isliulin/MingRui/Shell/面板壳体.STEP

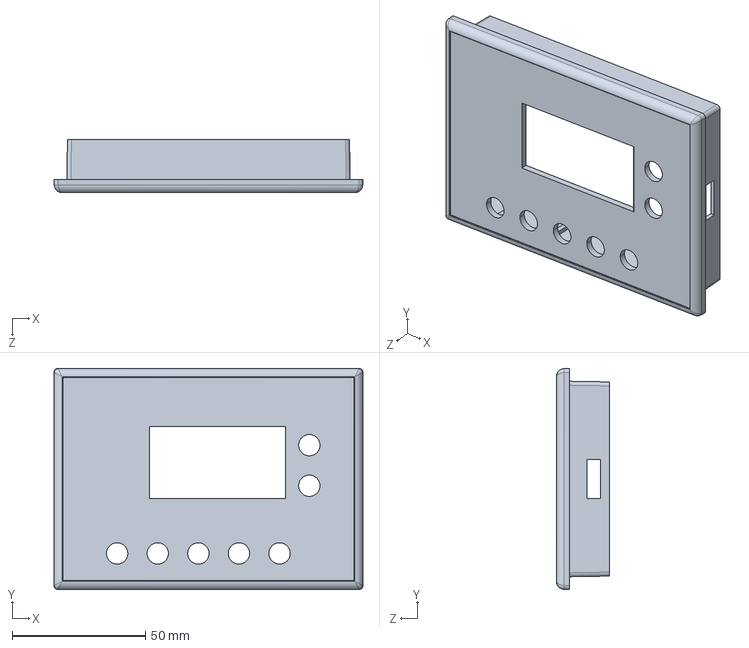
[picture p1: CAD file, 2016-09-27]
Shell/面板壳体.STEP
116.0 x 83.0 x 20.0 mm
