isliulin/MingRui/Shell/壳体后盖.STEP

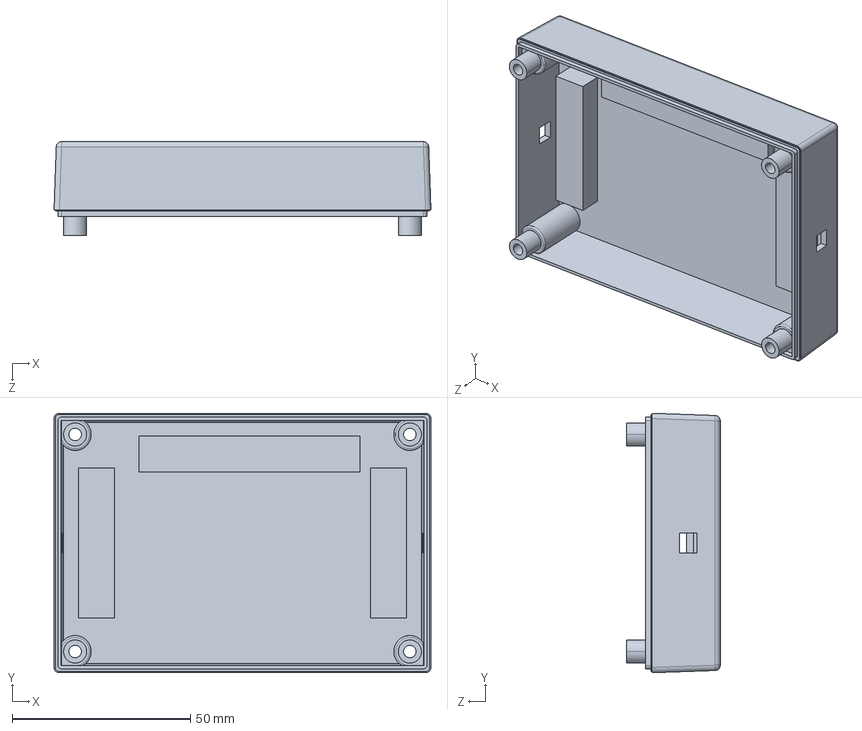
[picture p2: CAD file, 2016-09-27]
Shell/壳体后盖.STEP
105.9 x 72.9 x 26.3 mm
