isliulin/MingRui/(list of files, cad)

Other CAD files:
PCB/KYJ.DWG
Shell/壳体后盖.x_t
Shell/面板壳体.x_t
