isliulin/MingRui/DOC/test.txt

2016-8-25
出现厂家参数设置数值混乱，导致过温保护。重新设置参数后运行正常。

问题建议：保存参数时出现错误，建议加大电源电容。检测到断电时，先关闭液晶背光，再保存数据。

2016-8-26
再次报告出现过温保护，无法清除。检查停机温度设置值是151，改成105后，故障可以清除，能正常启动。

问题建议：检查代码。保存参数时是否出现问题。
