isliulin/MingRui/PCB/KYJ.PDF

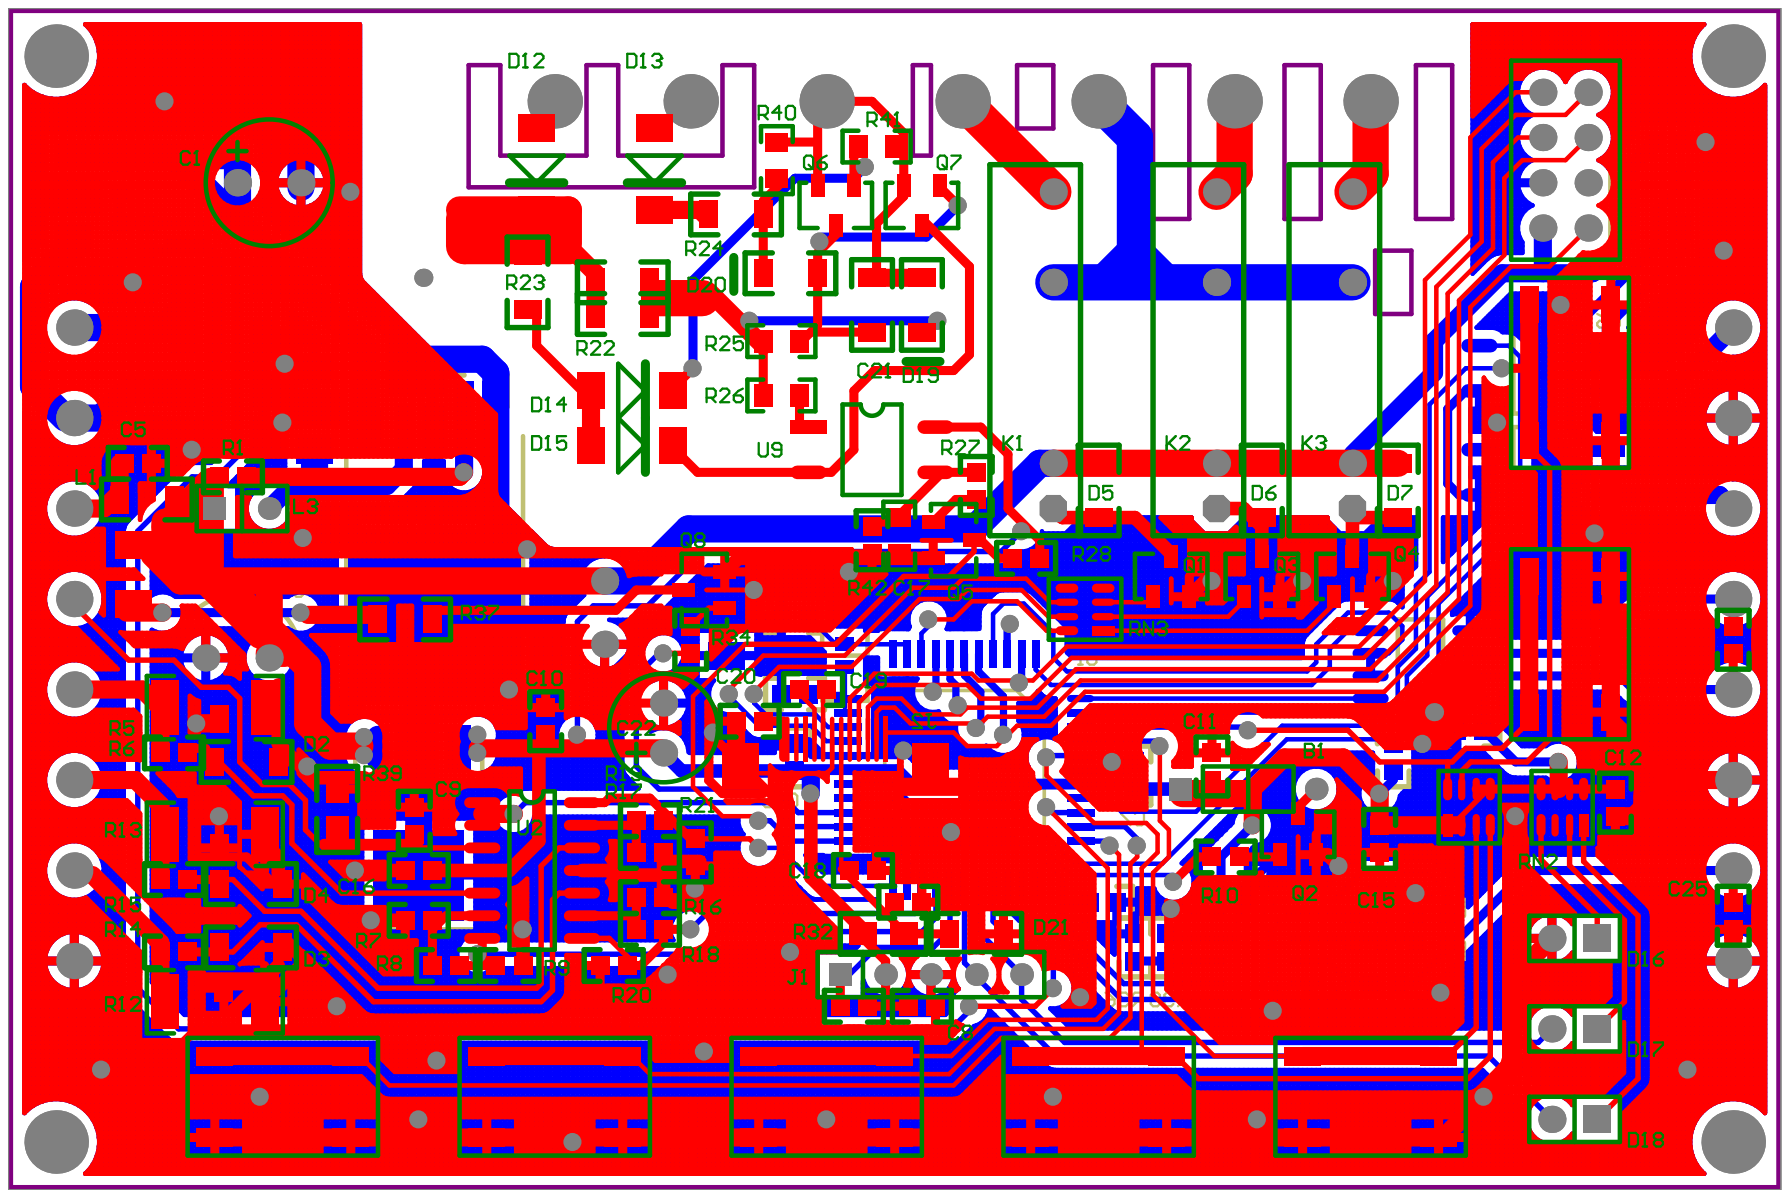
[picture p3: page 1]

Board St
