isliulin/MingRui/(list of files, drawings)

Other design files:
PCB/KYJ.PCB
PCB/KYJController.PCB
PCB/矩阵开关.pcb
