isliulin/MingRui/KYJ.X/SRC/KYJDEF.c

#include "KYJDEF.h"
#include "LCD_LIXIAN.h"
#include "key.h"
#include "adc.h"
#include "EEPROM.h"
#include "delay.h"

volatile unsigned int nADVref=5000;  //AD参考电压，单位：mV
struct KYJ_s sKYJ;
bit bRefreshInterface;
unsigned char nMenuIndex;  //当前菜单序号  1-运行参数；2-用户参数；3-厂家参数；4-注册参数；5-用户密码
unsigned char nParamIndex;   //当前参数序号
unsigned char nDigitIndex; //当前数位
int nParamValue;
int nPassValue;

unsigned int nCurrentLimit12Count;
unsigned int nCurrentLimit13Count;
unsigned char nCurrentLimit15Count;
unsigned char nCurrentLimit16Count;
unsigned char nCurrentLimit20Count;
unsigned char nCurrentLimit30Count;
unsigned char nCurrentLimit0Count;
unsigned char nCurrentNotBalanceCount;
unsigned char nCurrentNotBalance0Count;


unsigned long nCurrent;  //电流采样累加值
unsigned char nCurrentSampleCount;  //电流采样次数，1ms采样一次，每20ms（对应50Hz）计算平均值
unsigned long nLongTemp; //32位临时变量
bit nRet;
int nSampleValue;
unsigned int nLeftTime;
void KYJ_Init(void)
{
    nCurrent=0;
    nCurrentSampleCount=0;
    nCurrentLimit12Count = 0;
    nCurrentLimit13Count = 0;
    nCurrentLimit15Count = 0;
    nCurrentLimit16Count = 0;
    nCurrentLimit20Count = 0;
    nCurrentLimit30Count = 0;
    nCurrentLimit0Count = 0;
    nCurrentNotBalanceCount = 0;
    nCurrentNotBalance0Count = 0;
    
    sKYJ.nStatus = STATUS_POWERSTOP;
    sKYJ.nFaultFlag = 0;
    sKYJ.nStatusTimeElapse = 0;
    sKYJ.nInterface = 0; //设成0后会自动切换到main界面
    sKYJ.nInterfaceTimeElapse = 0;
    FAN_SW_OFF;
    MOTOR_SW_OFF;
    LOAD_SW_OFF;
}

void KYJ_Param_Default(void)
{
    sKYJ.nPressure = 0;
    sKYJ.nTemperature = 0;
    sKYJ.nVoltage = 0;
    sKYJ.nValidateParamResult = 0;
    sKYJ.nUserPass = 0;
    sKYJ.nFactoryPass = 0;
    
    sKYJ.sUserParam.nLoadPress = 60;//加载压力
    sKYJ.sUserParam.nUnLoadPress = 70;//卸载压力
    sKYJ.sUserParam.nFanStartTemp = 70; //风机启温度
    sKYJ.sUserParam.nFanStopTemp = 66;//风机停温度
    sKYJ.sUserParam.nMCUDelayTime = 8; //主机延时时间，单位：秒
    sKYJ.sUserParam.nSADelayTime = 6; //星角延时时间，单位：秒
    sKYJ.sUserParam.nLoadDelayTime = 2; //加载延时时间，单位：秒
    sKYJ.sUserParam.nNoLoadDelayTime = 120; //空载延时时间
    sKYJ.sUserParam.nStopDelayTime =10; //停机延时时间
    sKYJ.sUserParam.nRestartDelayTime = 60; //重启延时时间
    sKYJ.sUserParam.nStartStopMode = 0; //启停方式
    sKYJ.sUserParam.nLoadMode = 1; //加载方式
    sKYJ.sUserParam.nCommMode = 0 ; //通讯方式
    sKYJ.sUserParam.nCommCode = 16; //通讯编码
    sKYJ.sUserParam.nSlaveMode = 0; //联动状态
    sKYJ.sUserParam.nInTurnTime = 99; //轮换时间，单位：小时
    sKYJ.sUserParam.nSlaveCount = 0; //联动机数
    sKYJ.sUserParam.nSlaveLoadPress = 70;//联动加载压力
    sKYJ.sUserParam.nSlaveUnLoadPress = 90;//联动卸载压力
    sKYJ.sUserParam.nSlaveDelayTime = 50;//联动延时时间
    sKYJ.sUserParam.nOilFilterTime = 0;//油滤器时间复位
    sKYJ.sUserParam.nOilDeployTime = 0;//油分器时间复位
    sKYJ.sUserParam.nAirFilterTime = 0; //空滤器时间复位
    sKYJ.sUserParam.nOil2Time = 0; //润滑油时间复位
    sKYJ.sUserParam.nOil3Time = 0; //润滑脂时间复位
    sKYJ.sUserParam.nBeltTime = 0; //皮带时间复位
    sKYJ.sUserParam.nOilFilterPresetTime = 0; //油滤器时间预置
    sKYJ.sUserParam.nOilDeployPresetTime = 0; //油分器时间预置
    sKYJ.sUserParam.nAirFilterPresetTime = 0; //空滤器时间预置
    sKYJ.sUserParam.nOil2PresetTime = 0; //润滑油时间预置
    sKYJ.sUserParam.nOil3PresetTime = 0; //润滑脂时间预置
    sKYJ.sUserParam.nBeltPresetTime = 0; //皮带时间预置
    sKYJ.sUserParam.nLanguage = 1;//中文/英文
    sKYJ.sUserParam.nPassword = 0000;//修改用户密码
    
    
    sKYJ.sFactoryParam.nMainMotorNormalCurrent = 200;  //主机额定电流
    sKYJ.sFactoryParam.nWarningTemp = 100; //排温预警温度
    sKYJ.sFactoryParam.nStopTemp = 105;//排温停机温度
    sKYJ.sFactoryParam.nStopPress = 90; //供气停机压力
    sKYJ.sFactoryParam.nUnloadPressLimit= 80; //卸载压力高限
    sKYJ.sFactoryParam.nTotalRunTime = 0; //运行总时间
    sKYJ.sFactoryParam.nTotalLoadTime = 0; //负载总时间
    sKYJ.sFactoryParam.nHistoryFaultRest = 0; //历史故障复位
    sKYJ.sFactoryParam.nCurrentNotBalance = 15; //电流不平衡度
    sKYJ.sFactoryParam.nNoPhaseProtectTime = 2; //断相保护时间
    sKYJ.sFactoryParam.nProductDate = 160101; //出厂日期
    sKYJ.sFactoryParam.nProductSN = 0;//出厂编号
    sKYJ.sFactoryParam.nPhaseProtect = 1; //相序保护
    sKYJ.sFactoryParam.nFreqSelect = 0; //频率选择
    sKYJ.sFactoryParam.nCooperationMode = 0; //联动方式
    sKYJ.sFactoryParam.nLowTempProtect = 5; //低温保护
    sKYJ.sFactoryParam.nTimeLimit = 0;//时限
    sKYJ.sFactoryParam.nWarningOverTime = 10;//预警过久停机
    sKYJ.sFactoryParam.nCommParam = 0;//通信预置参数
    //sKYJ.sFactoryParam.nParam1 = 0;//参数1
     sKYJ.sFactoryParam.nStartType = 0;  //默认直接启动   
    
    sKYJ.sRegParam.nStandCurrentA = 0;//标准电流
    sKYJ.sRegParam.nStandCurrentAFactor = 1000;//系数
    sKYJ.sRegParam.nCurrentA = 0;//现行电流
    sKYJ.sRegParam.nStandCurrentB = 0;//标准电流
    sKYJ.sRegParam.nStandCurrentBFactor = 1000;//系数
    sKYJ.sRegParam.nCurrentB = 0;//现行电流
    sKYJ.sRegParam.nStandCurrentC = 0; //标准电流
    sKYJ.sRegParam.nStandCurrentCFactor = 1000;//系数
    sKYJ.sRegParam.nCurrentC = 0;//现行电流
    sKYJ.sRegParam.nStandTemp = 25;//标准温度
    sKYJ.sRegParam.nStandTempFactor = 1000;//系数
    sKYJ.sRegParam.nZeroBias = 0;//零点
    sKYJ.sRegParam.nTemp = 0;//现行温度
    sKYJ.sRegParam.nStandVoltage = 220; //标准电压
    sKYJ.sRegParam.nVoltage = 0; //现行电压
    sKYJ.sRegParam.nStandVoltageFactor = 1000; //电压系数,0.001
    sKYJ.sRegParam.nCurrMode = 0;//CURR MODE

    sKYJ.sPassword.nOpPass = 0000; //操作密码
    sKYJ.sPassword.nUserPass = 1111; //用户密码
    sKYJ.sPassword.nSalePass = 2222; //销售密码
    sKYJ.sPassword.nFactoryPass = 3333; //厂家密码
    sKYJ.sPassword.nRegPass = 4444;//校准密码
    sKYJ.sPassword.nSuperPass = 5555;//厂家超级密码
}

bit KYJ_CheckStatus(unsigned char nStatus)
{
    int nCurrentMax,nCurrentMin;
    nRet = 0;
    switch(nStatus)
    {
        case STATUS_POWERSTOP:
            break;
        case STATUS_KEYSTOP:
            if(sKYJ.nStatus != STATUS_KEYSTOP && sKYJ.nStatus != STATUS_FAULTSTOP && Key_Press(KEY_STOP)) nRet=1;
            if(sKYJ.nStatus == STATUS_FAULTSTOP && sKYJ.nFaultFlag == 0) nRet = 1;
            
            //按下紧急停止按钮
            //if(Key_Press(KEY_EMERGY_STOP)) {LOAD_SW_OFF;MOTOR_SW_OFF;FAN_SW_OFF;nRet=1;}
            if(KEY_EMERGY_STOP_PIN == 1)
            {
                DelayUs(100);
                if(KEY_EMERGY_STOP_PIN == 1)
                {
                    LOAD_SW_OFF;
                    MOTOR_SW_OFF;
                    FAN_SW_OFF;
                    nRet=1;
                }
            }
            break;
        case STATUS_DELAYSTOP:
            if(sKYJ.nStatus == STATUS_UNLOAD && sKYJ.nStatusTimeElapse > sKYJ.sUserParam.nNoLoadDelayTime) nRet = 1;
            break;
        case STATUS_FAULTSTOP:
            //if(sKYJ.nStatus !=STATUS_FAULTSTOP)
            //相序和缺相检测
            if(!(sKYJ.nFaultFlag&0x01) && !PORTAbits.RA4) {sKYJ.nFaultFlag |= 0x01;nRet=1;}
            else if(PORTAbits.RA4) sKYJ.nFaultFlag &= 0xFE;
            
            if(!(sKYJ.nStatus & 0xF0) && !(sKYJ.nStatus == STATUS_STARTUP && sKYJ.nStatusTimeElapse <sKYJ.sUserParam.nMCUDelayTime)) //如果在启动时间内，则不检测电流不平衡
            {
                //电流不平衡检测，是否需要在主机延时时间以后才检测？
                nCurrentMax = max(sKYJ.nCurrentA,sKYJ.nCurrentB);
                nCurrentMax = max(nCurrentMax,sKYJ.nCurrentC);
                nCurrentMin = min(sKYJ.nCurrentA,sKYJ.nCurrentB);
                nCurrentMin = min(nCurrentMin,sKYJ.nCurrentC); 
                
                if(sKYJ.sFactoryParam.nCurrentNotBalance < 15 &&   //不平衡度设置值大于等于15，则不检测电流不平衡
                        !(sKYJ.nFaultFlag&0x02)
                        )
                {

                        if(nCurrentMax > (nCurrentMin*(10+sKYJ.sFactoryParam.nCurrentNotBalance)/10))
                        {
                            nCurrentNotBalanceCount++;
                        }
                        else
                        {
                            nCurrentNotBalance0Count++;
                        }
                        
                        if(nCurrentNotBalance0Count>7)
                        {
                            nCurrentNotBalance0Count=0;
                            nCurrentNotBalanceCount=0;
                        }
                        else if(nCurrentNotBalanceCount>40)  //动作时间5秒钟
                        {
                            nCurrentNotBalance0Count=0;
                            nCurrentNotBalanceCount=0;
                            sKYJ.nFaultFlag |= 0x02;
                            nRet=1;                           
                        }

                }
                //过载保护，在主机延时时间以后才检测
//                if(!(sKYJ.nFaultFlag&0x20) && 
//                        nCurrentMax > (sKYJ.sFactoryParam.nMainMotorNormalCurrent * 12 /10))   //大于额定电流1.2倍
                if(!(sKYJ.nFaultFlag&0x20))
                {
                    if(nCurrentMax > (sKYJ.sFactoryParam.nMainMotorNormalCurrent * 30 /10))
                        nCurrentLimit30Count++;
                    else if(nCurrentMax > sKYJ.sFactoryParam.nMainMotorNormalCurrent * 20 /10)
                        nCurrentLimit20Count++;
                    else if(nCurrentMax > sKYJ.sFactoryParam.nMainMotorNormalCurrent * 16 /10)
                        nCurrentLimit16Count++;
                    else if(nCurrentMax > sKYJ.sFactoryParam.nMainMotorNormalCurrent * 15 /10)
                        nCurrentLimit15Count++;
                    else if(nCurrentMax > sKYJ.sFactoryParam.nMainMotorNormalCurrent * 13 /10)
                        nCurrentLimit13Count++;
                    else if(nCurrentMax > sKYJ.sFactoryParam.nMainMotorNormalCurrent * 12 /10)
                        nCurrentLimit12Count++;
                    else
                        nCurrentLimit0Count++;
                    if(nCurrentLimit0Count>7)  //如果有1秒时间里正常，则全部清零，运行周期125ms
                    {
                        nCurrentLimit12Count = 0;
                        nCurrentLimit13Count = 0;
                        nCurrentLimit15Count = 0;
                        nCurrentLimit16Count = 0;
                        nCurrentLimit20Count = 0;
                        nCurrentLimit30Count = 0;
                        nCurrentLimit0Count = 0;
                    }
                    else if(nCurrentLimit12Count>384
                            || nCurrentLimit13Count>192
                            || nCurrentLimit15Count>64
                            || nCurrentLimit16Count>40
                            || nCurrentLimit20Count>8
                            || nCurrentLimit30Count>0)  //反时限保护
                    {
                        nCurrentLimit12Count = 0;
                        nCurrentLimit13Count = 0;
                        nCurrentLimit15Count = 0;
                        nCurrentLimit16Count = 0;
                        nCurrentLimit20Count = 0;
                        nCurrentLimit30Count = 0;
                        nCurrentLimit0Count = 0;
                        
                        sKYJ.nFaultFlag |=0x20;
                        nRet=1;
                    }
                }
            }
            //超压检测
            if(!(sKYJ.nFaultFlag&0x08) && sKYJ.nPressure > sKYJ.sFactoryParam.nStopPress)
            {
                sKYJ.nFaultFlag | =0x08;
                nRet=1;
            }

            //低温保护
            if(!(sKYJ.nFaultFlag&0x10) && sKYJ.nTemperature < (- sKYJ.sFactoryParam.nLowTempProtect)) 
            {
                sKYJ.nFaultFlag |=0x10;
                nRet=1;
            }

            //电源电压保护
            if(!(sKYJ.nFaultFlag&0x40) && (sKYJ.nVoltage<180 || sKYJ.nVoltage> 240))
            {
                sKYJ.nFaultFlag|=0x40;
                //如果是电压偏低，可能是掉电了，保存参数
                //改为在switch to keystop里面保存
//                if(sKYJ.nVoltage<180)
//                {
//                    LED_OFF;
//                    EEPROM_Save_Counter();
//                    LED_ON;
//                }
                nRet = 1;
            }

            //压力传感器故障，如果检测到的电流<4mA，则测量值为0
            if(!(sKYJ.nFaultFlag&0x80) && (sKYJ.sRunParam.nPressure < -10))
            {
                sKYJ.nFaultFlag |= 0x80;
                nRet = 1;
            }

            //温度传感器故障，如果检测到的温度值大于1000，则很有可能温度传感器没接
            if(!(sKYJ.nFaultFlag&0x100) && (sKYJ.nTemperature >= 280))
            {
                sKYJ.nFaultFlag |= 0x100;
                nRet = 1;
            }
            else if(!(sKYJ.nFaultFlag&0x04) && sKYJ.nTemperature > (int)sKYJ.sFactoryParam.nStopTemp) //不超过1000，则进行过热检测
            {
                sKYJ.nFaultFlag |= 0x04; 
                nRet=1;
            }
            
            //如果参数错误，也要报故障停止
            if(!(sKYJ.nFaultFlag&0x200) && (sKYJ.nValidateParamResult !=0))
            {
                sKYJ.nFaultFlag |= 0x200; 
                nRet=1;               
            }
            break;
        case STATUS_STARTUP:
            if(sKYJ.nFaultFlag == 0)  //有错误时，不能直接启动，必须按OK键先清除错误；没错误时，可以启动
            {
                if(sKYJ.nStatus == STATUS_POWERSTOP && Key_Release(KEY_START))
                    nRet = 1;
                else if(sKYJ.nStatusTimeElapse>sKYJ.sUserParam.nRestartDelayTime)
                {
                    if(Key_Release(KEY_START) ) nRet = 1;
                    if(sKYJ.nStatus == STATUS_DELAYSTOP && sKYJ.nPressure < sKYJ.sUserParam.nLoadPress) nRet=1;
                }
            }
            break;
        case STATUS_LOAD:
            if(sKYJ.sUserParam.nLoadMode == 0) //如果是手动方式
            {
                if((sKYJ.nStatus & (STATUS_STARTUP | STATUS_UNLOAD)) && sKYJ.nStatusTimeElapse > sKYJ.sUserParam.nLoadDelayTime)
                {
                    if(sKYJ.nInterface == INTERFACE_MAIN && sKYJ.nPressure < sKYJ.sUserParam.nUnLoadPress && Key_Release(KEY_OK)) nRet = 1;
                }
            }
            else  //自动方式
            {
                if(sKYJ.nStatus == STATUS_STARTUP)
                {
                    if(sKYJ.nStatusTimeElapse > (sKYJ.sUserParam.nMCUDelayTime + sKYJ.sUserParam.nLoadDelayTime) && sKYJ.nPressure < sKYJ.sUserParam.nUnLoadPress)
                        nRet = 1;
                    
                    //位于主界面时，如果压力低于卸载压力，按下确认键，可以手动加载
                    if(sKYJ.nInterface == INTERFACE_MAIN && sKYJ.nPressure < sKYJ.sUserParam.nUnLoadPress && Key_Release(KEY_OK)) nRet = 1;
                }
                
                if(sKYJ.nStatus == STATUS_UNLOAD)
                {
                    if(sKYJ.nStatusTimeElapse > sKYJ.sUserParam.nLoadDelayTime) 
                    {
                        if(sKYJ.nPressure < sKYJ.sUserParam.nLoadPress) nRet = 1;
                        //位于主界面时，如果压力低于卸载压力，按下确认键，可以手动加载
                        if(sKYJ.nInterface == INTERFACE_MAIN && sKYJ.nPressure < sKYJ.sUserParam.nUnLoadPress && Key_Release(KEY_OK)) nRet = 1;
                    }
                }
            }
            break;
        case STATUS_UNLOAD:
            if(sKYJ.sUserParam.nLoadMode == 0) //如果是手动方式
            {
                if(sKYJ.nInterface == INTERFACE_MAIN && sKYJ.nPressure > sKYJ.sUserParam.nLoadPress && Key_Release(KEY_OK)) nRet = 1;
            }
            else //自动方式
            {
                if(sKYJ.nStatus == STATUS_LOAD && sKYJ.nPressure > sKYJ.sUserParam.nUnLoadPress) nRet = 1;
                if(sKYJ.nStatus == STATUS_STARTUP)
                {
                    if((sKYJ.nStatusTimeElapse > (sKYJ.sUserParam.nMCUDelayTime+sKYJ.sUserParam.nLoadDelayTime)) && (sKYJ.nPressure > sKYJ.sUserParam.nUnLoadPress)) nRet = 1;           
                }
                //位于主界面时，如果压力高于加载压力，按下确认键，可以手动卸载
                if(sKYJ.nInterface == INTERFACE_MAIN && 
                        sKYJ.nStatus == STATUS_LOAD &&
                        sKYJ.nPressure > sKYJ.sUserParam.nLoadPress && 
                        Key_Release(KEY_OK)) 
                    nRet = 1;
            }
            break;
        case STATUS_MANUAL:
            break;
        default:
            break;
    }
    return nRet;    
}

void KYJ_SwitchToStatus(unsigned char nStatus)
{
    switch(nStatus)
    {
        case STATUS_FAULTSTOP:
            LED_ERROR_ON;
            LED_ERROR_ON; //给两次就能点亮？
            
            //是否需要立即关闭主机和风扇？
            LOAD_SW_OFF;
            FAN_SW_OFF;
            MOTOR_SW_OFF;
            BEEP_ON;
            break;
        case STATUS_POWERSTOP:
            LED_RUN_OFF;
            LED_RUN_OFF;
            LOAD_SW_OFF;            
            break;
        case STATUS_KEYSTOP:
            LED_RUN_OFF;
            LOAD_SW_OFF;
            EEPROM_Save_Counter();
            break;
        case STATUS_DELAYSTOP:
            LED_RUN_OFF;
            LOAD_SW_OFF;
            MOTOR_SW_OFF;
            break;
        case STATUS_STARTUP:
            LED_RUN_ON;
            
            if(sKYJ.sFactoryParam.nStartType == 1) //星角启动
            {
                MOTOR_SW_ON;  
            }
            else
            {
                MOTOR_SW_ON;  //直接启动
            }
            //sKYJ.nFaultFlag=0;  //错误标志清零
            LED_ERROR_OFF;
            break;
        case STATUS_LOAD:
            LOAD_SW_ON;
            break;
        case STATUS_UNLOAD:
            LOAD_SW_OFF;
            break;
        case STATUS_MANUAL:
            break;
        default:
            break;
    }
    sKYJ.nStatus = nStatus;
    sKYJ.nStatusTimeElapse = 0;
    return;      
}

void KYJ_ExcecuteStatus(void)
{
    switch(sKYJ.nStatus)
    {
        case STATUS_POWERSTOP:
            //break;
        case STATUS_KEYSTOP:
            if(sKYJ.nStatusTimeElapse > sKYJ.sUserParam.nStopDelayTime) {LOAD_SW_OFF;MOTOR_SW_OFF;FAN_SW_OFF;}
            break;
        case STATUS_DELAYSTOP:
            if(sKYJ.nStatusTimeElapse < 2)  //在空久停机的最初一段时间内，把所有继电器多关几遍！
            {
                MOTOR_SW_OFF;
                FAN_SW_OFF;
                LOAD_SW_OFF;
            }
            break;
        case STATUS_FAULTSTOP:
            if(sKYJ.nStatusTimeElapse > 0 && sKYJ.nStatusTimeElapse <2)
            {
                MOTOR_SW_OFF;
                FAN_SW_OFF;
                LOAD_SW_OFF;
            }
            if(Key_Press(KEY_OK))
            {
                BEEP_OFF;
                LED_ERROR_OFF;
                sKYJ.nFaultFlag=0;  //按下OK键，则错误标志清零。
            }
            break;
        case STATUS_STARTUP:
            if(sKYJ.sFactoryParam.nStartType == 1) //星角启动
            {
                if(sKYJ.nStatusTimeElapse < sKYJ.sUserParam.nSADelayTime)
                {
                    MOTOR_SW_ON;
                    FAN_SW_ON;
                }
                else
                {
                    FAN_SW_OFF;
                }
            }
            else
            {
                MOTOR_SW_ON;  //直接启动
            }
            break;
        case STATUS_LOAD:
            //break;
        case STATUS_UNLOAD:
            //需要确认下，风扇是否在加载/卸载运行过程中自动启停。在主机启动后是否需要启停？会否影响星角启动？
            if(sKYJ.nTemperature > (int)sKYJ.sUserParam.nFanStartTemp) 
                FAN_SW_ON;
            else if(sKYJ.nTemperature < (int)sKYJ.sUserParam.nFanStopTemp) 
                FAN_SW_OFF;
            break;
        case STATUS_MANUAL:
            break;
        default:
            break;
    }
    return;      
}

bit KYJ_CheckInterface(unsigned char nInterface)
{
    nRet = 0;
    switch(nInterface)
    {
        case INTERFACE_MAIN:
            if(sKYJ.nInterface == 0 ||
                    (sKYJ.nInterface!=INTERFACE_MAIN && sKYJ.nInterfaceTimeElapse > 30) ||  //在其他界面没有按键操作达30秒 
                    (sKYJ.nInterface == INTERFACE_MENU && Key_Release(KEY_RESET))
                    ) nRet = 1;
            break;
        case INTERFACE_MENU:
            if(sKYJ.nInterface == INTERFACE_MAIN && Key_Release(KEY_DOWN)) nRet = 1;
            if((sKYJ.nInterface == INTERFACE_RUNPARAM || 
                    sKYJ.nInterface==INTERFACE_USERPARAM || 
                    sKYJ.nInterface==INTERFACE_FACTORYPARAM|| 
                    sKYJ.nInterface==INTERFACE_REGPARAM|| 
                    sKYJ.nInterface==INTERFACE_PASSWORD) && 
                    Key_Release(KEY_RESET)) nRet = 1;
            break;
        case INTERFACE_RUNPARAM:
            if(sKYJ.nInterface == INTERFACE_MENU && nMenuIndex == 1 && Key_Release(KEY_MOVE)) nRet = 1;
            if(sKYJ.nInterface == INTERFACE_PARAM && nMenuIndex == 1 && Key_Release(KEY_RESET)) nRet = 1;
            break;
        case INTERFACE_USERPARAM:
            if(sKYJ.nInterface == INTERFACE_MENU && nMenuIndex == 2 && Key_Release(KEY_MOVE)) nRet = 1;
            if(sKYJ.nInterface == INTERFACE_PARAM && nMenuIndex == 2 && Key_Release(KEY_RESET)) nRet = 1;
            break;
        case INTERFACE_FACTORYPARAM:
            if(sKYJ.nInterface == INTERFACE_MENU && nMenuIndex == 3 && Key_Release(KEY_MOVE)) nRet = 1;
            if(sKYJ.nInterface == INTERFACE_PARAM && nMenuIndex == 3 && Key_Release(KEY_RESET)) nRet = 1;
            break;
        case INTERFACE_REGPARAM:
            if(sKYJ.nInterface == INTERFACE_MENU && nMenuIndex == 4 && Key_Release(KEY_MOVE)) nRet = 1;
            if(sKYJ.nInterface == INTERFACE_PARAM && nMenuIndex == 4 && Key_Release(KEY_RESET)) nRet = 1;
            break;
        case INTERFACE_PASSWORD:
            if(sKYJ.nInterface == INTERFACE_MENU && nMenuIndex == 5 && Key_Release(KEY_MOVE)) nRet = 1;
            if(sKYJ.nInterface == INTERFACE_PARAM && nMenuIndex == 5 && Key_Release(KEY_RESET)) nRet = 1;
            break;
        case INTERFACE_PARAM:
            if((sKYJ.nInterface == INTERFACE_USERPARAM || sKYJ.nInterface == INTERFACE_FACTORYPARAM || sKYJ.nInterface == INTERFACE_REGPARAM)
                    && Key_Release(KEY_MOVE)
                    ) nRet = 1;
            break;
        default:
            break;
    }
    return nRet;    
}

void KYJ_SwitchToInterface(unsigned char nInterface)
{
    if(nInterface != INTERFACE_PARAM) LcmClear(0x00);
    switch(nInterface)
    {
        case INTERFACE_MAIN:
                
                //LcmSetSongBuff(10,11,0,0,0,0,0,0); //温度
                //LcmPutSongStr(1,0,BuffCharDot,2,0);
                
                LcmSetSongBuff(12,0,0,0,0,0,0,0); //℃
                LcmPutSongStr(1,32,BuffCharDot,1,0);
                
                LcmPutStr(104,1,(unsigned char *)"MPa");
                
//                LcmSetSongBuff(13,14,15,17,18,0,0,0);//设备已停止
//                LcmPutSongStr(4,0,BuffCharDot,5,0);

                LcmSetSongBuff(19,0,0,0,0,0,0,0); //秒
                LcmPutSongStr(4,112,BuffCharDot,1,0);
                
                //密码清零
                sKYJ.nUserPass = 0;
                sKYJ.nFactoryPass = 0;

            break;
        case INTERFACE_MENU:
            nMenuIndex = 1;
            nParamIndex = 0;
            
            //重新初始化下液晶
            LcmInit();
            
            break;
        case INTERFACE_RUNPARAM:
//            if(nParamIndex==0)nParamIndex = 1;
//            break;
        case INTERFACE_USERPARAM:
//            if(nParamIndex==0)nParamIndex = 1;
//            break;
        case INTERFACE_FACTORYPARAM:
//            if(nParamIndex==0)nParamIndex = 1;
//            break;
        case INTERFACE_REGPARAM:
//            if(nParamIndex==0)nParamIndex = 1;
//            break;
        case INTERFACE_PASSWORD:
            if(nParamIndex==0)nParamIndex = 1;
            break;
        case INTERFACE_PARAM:
            //nParamIndex = 1;
            if((nMenuIndex==2 && sKYJ.nUserPass != sKYJ.sPassword.nUserPass)
                    || ((nMenuIndex==3||nMenuIndex==4) && sKYJ.nFactoryPass != sKYJ.sPassword.nFactoryPass))
            {
                //nPassValue = sKYJ.nUserPass;
                LcmClear(0);
                LcmSetSongBuff(38,39,40,41,0,0,0,0); //输入密码
                LcmPutSongStr(1,0,BuffCharDot,4,0);
                
                if(nMenuIndex==2)nPassValue = sKYJ.nUserPass;
                else if(nMenuIndex==3||nMenuIndex==4) nPassValue = sKYJ.nFactoryPass;
            }
            
            nDigitIndex = 1;
            break;
        default:
            break;
    }
    sKYJ.nInterface = nInterface;
    sKYJ.nInterfaceTimeElapse = 0;
    bRefreshInterface = 1;

    return;      
}

void KYJ_ExecuteInterface(void)
{
    //float fFactor;
    char tempValue[4];
    //如果有按键按下，则界面流逝归零
    if(!KEY_RESET_PIN || !KEY_OK_PIN || !KEY_UP_PIN|| !KEY_DOWN_PIN||!KEY_MOVE_PIN)
        sKYJ.nInterfaceTimeElapse = 0;
    switch(sKYJ.nInterface)
    {
        case INTERFACE_MAIN:
            switch(sKYJ.nStatus)
            {
                case STATUS_POWERSTOP:
                    LcmSetSongBuff(13,14,17,18,30,0,0,0);//设备已停止
                    LcmPutSongStr(4,0,BuffCharDot,5,0);
                    LcmPutFixDigit(4,79,0,4,0);  //开机后显示启动剩余时间为0
                    LcmSetSongBuff(19,0,0,0,0,0,0,0); //秒
                    LcmPutSongStr(4,112,BuffCharDot,1,0);                    
                    break;
                case STATUS_KEYSTOP:
                    LcmSetSongBuff(13,14,17,18,30,0,0,0);//设备停止
                    nLeftTime = 0;                        

                    //显示停机延时剩余时间
                    if(sKYJ.nStatusTimeElapse <= sKYJ.sUserParam.nStopDelayTime)
                    {
                        LcmSetSongBuff(17,9,37,33,30,0,0,0);//停机延时
                        nLeftTime = (sKYJ.nStatusTimeElapse > sKYJ.sUserParam.nStopDelayTime)? 0 : (sKYJ.sUserParam.nStopDelayTime - sKYJ.nStatusTimeElapse);
                    }
                    else if(sKYJ.nStatusTimeElapse <= sKYJ.sUserParam.nRestartDelayTime)
                    {
                        LcmSetSongBuff(44,31,37,33,30,0,0,0);//重启延时
                        nLeftTime = sKYJ.sUserParam.nRestartDelayTime - sKYJ.nStatusTimeElapse;
                    }
                    LcmPutSongStr(4,0,BuffCharDot,5,0); 
                    LcmPutFixDigit(4,79,nLeftTime,4,0);
                    LcmSetSongBuff(19,0,0,0,0,0,0,0); //秒
                    LcmPutSongStr(4,112,BuffCharDot,1,0);
                    break;
                case STATUS_DELAYSTOP:
                    LcmSetSongBuff(13,14,17,18,30,0,0,0);//设备停止
                    LcmPutSongStr(4,0,BuffCharDot,5,0);

                    nLeftTime = 0; //空久时间到，则立即关闭主机
                    //显示重启延时剩余时间
                    nLeftTime = (sKYJ.nStatusTimeElapse > sKYJ.sUserParam.nRestartDelayTime)? 0 : (sKYJ.sUserParam.nRestartDelayTime - sKYJ.nStatusTimeElapse);
                    LcmPutFixDigit(4,79,nLeftTime,4,0);
                    LcmSetSongBuff(19,0,0,0,0,0,0,0); //秒
                    LcmPutSongStr(4,112,BuffCharDot,1,0);
                    break;
                case STATUS_FAULTSTOP:
                    if(sKYJ.nFaultFlag & 0x0100) //温度故障
                    {
                        LcmSetSongBuff(10,11,91,92,30,0,0,0);
                    }
                    else if(sKYJ.nFaultFlag & 0x80)  //压力故障
                    {
                        LcmSetSongBuff(7,56,91,92,30,0,0,0);
                    }
                    else if(sKYJ.nFaultFlag & 0x40) //电压保护
                    {
                        LcmSetSongBuff(79,7,98,99,30,0,0,0);
                    }
                    else if(sKYJ.nFaultFlag & 0x20) //过载保护
                    {
                        LcmSetSongBuff(110,36,98,99,30,0,0,0);
                    }
                    else if(sKYJ.nFaultFlag & 0x10) //低温保护
                    {
                        LcmSetSongBuff(109,10,98,99,30,0,0,0);
                    }
                    else if(sKYJ.nFaultFlag & 0x08) //过压保护
                    {
                        LcmSetSongBuff(110,7,98,99,30,0,0,0);
                    }
                    else if(sKYJ.nFaultFlag & 0x04) //过热保护
                    {
                        LcmSetSongBuff(110,10,98,99,30,0,0,0);
                    }
                    else if(sKYJ.nFaultFlag & 0x02) //电流不平衡
                    {
                        LcmSetSongBuff(79,80,93,94,95,0,0,0);
                    }
                    else if(sKYJ.nFaultFlag & 0x01) //相序保护
                    {
                        LcmSetSongBuff(97,108,98,99,30,0,0,0);
                    }
                    else if(sKYJ.nFaultFlag & 0x200) //参数保护
                    {
                        LcmSetSongBuff(22,23,98,99,30,0,0,0);
                    }
                    else
                    {
                        //LcmSetSongBuff(13,14,15,17,18,0,0,0);//设备已停止
                        ;
                    }
                    //显示故障代码
                    LcmPutSongStr(4,0,BuffCharDot,5,0);
                    
                    if(sKYJ.nFaultFlag == 0x200) LcmPutFixDigit(4,79,sKYJ.nValidateParamResult,4,0);
                    else LcmPutFixDigit(4,79,sKYJ.nFaultFlag,4,0);
                    LcmPutStr(111,4,(unsigned char *)"  "); //把秒覆盖掉
                    break;
                case STATUS_STARTUP:
                    //显示加载延时剩余时间
                    nLeftTime = 0;
                    LcmSetSongBuff(13,14,31,32,30,0,0,0);//设备已启动
                    if(sKYJ.sFactoryParam.nStartType == 1)//如果是星角启动
                    {
                        if(sKYJ.nStatusTimeElapse <= sKYJ.sUserParam.nSADelayTime)
                        {
                            nLeftTime = sKYJ.sUserParam.nSADelayTime - sKYJ.nStatusTimeElapse;
                            LcmSetSongBuff(120,121,37,33,30,0,0,0);//星角延时：
                        }
                        else if (sKYJ.nStatusTimeElapse <= (sKYJ.sUserParam.nMCUDelayTime+sKYJ.sUserParam.nLoadDelayTime))
                        {
                            nLeftTime = (sKYJ.sUserParam.nMCUDelayTime+sKYJ.sUserParam.nLoadDelayTime) - sKYJ.nStatusTimeElapse;
                            LcmSetSongBuff(35,36,37,33,30,0,0,0);//加载延时：
                        }
                    }
                    else
                    {
                        if(sKYJ.nStatusTimeElapse <= (sKYJ.sUserParam.nMCUDelayTime+sKYJ.sUserParam.nLoadDelayTime))
                        {
                            nLeftTime = (sKYJ.sUserParam.nMCUDelayTime+sKYJ.sUserParam.nLoadDelayTime) - sKYJ.nStatusTimeElapse;
                            LcmSetSongBuff(35,36,37,33,30,0,0,0);//加载延时：
                        }
                    }
                    
                    LcmPutSongStr(4,0,BuffCharDot,5,0);
                    LcmPutFixDigit(4,79,nLeftTime,4,0);
                    LcmSetSongBuff(19,0,0,0,0,0,0,0); //秒
                    LcmPutSongStr(4,112,BuffCharDot,1,0);                    
                    break;
                case STATUS_LOAD:
                    LcmSetSongBuff(13,14,35,36,30,0,0,0);//设备已加载
                    LcmPutSongStr(4,0,BuffCharDot,5,0);
                    //显示0剩余时间
                    LcmPutFixDigit(4,79,0,4,0);
                    LcmSetSongBuff(19,0,0,0,0,0,0,0); //秒
                    LcmPutSongStr(4,112,BuffCharDot,1,0);                    
                    break;
                case STATUS_UNLOAD:
                    LcmSetSongBuff(13,14,57,36,30,0,0,0);//设备已卸载
                    LcmPutSongStr(4,0,BuffCharDot,5,0);
                    //显示空车延时剩余时间
                    nLeftTime = (sKYJ.nStatusTimeElapse > sKYJ.sUserParam.nNoLoadDelayTime)? 0 : (sKYJ.sUserParam.nNoLoadDelayTime - sKYJ.nStatusTimeElapse);
                    LcmPutFixDigit(4,79,nLeftTime,4,0);
                    LcmSetSongBuff(19,0,0,0,0,0,0,0); //秒
                    LcmPutSongStr(4,112,BuffCharDot,1,0);                    
                    break;
                case STATUS_MANUAL:
                    break;
                default:
                    break;
            
            }
//            LcmPutSongStr(4,0,BuffCharDot,5,0);
            
            //显示温度
            if(sKYJ.nTemperature<0)
                LcmPutFixDigit(1,0,sKYJ.nTemperature,2,0);
            else
                LcmPutFixDigit(1,0,sKYJ.nTemperature,3,0);

            //显示压力
            //LcmPutFixDigit(1,79,sKYJ.sRunParam.fPressure,4,0);
            LcmPutFloatDigit(1,64,sKYJ.nPressure,4,0,2);
            
            //显示调试信息
            //LcmPutFixDigit(6,30,sKYJ.nStatus,4,0);
            //LcmPutFixDigit(6,30,nCurrentLimit12Count,4,0);
            break;
        case INTERFACE_MENU:
            if(Key_Release(KEY_DOWN))
            {
                nMenuIndex++;
                if(nMenuIndex> 4) nMenuIndex = 1;  //暂时不要密码设置，最大值为4，如果密码设置，则最大值为5
                bRefreshInterface = 1;
            }
            else if(Key_Release(KEY_UP))
            {
                nMenuIndex--;
                if(nMenuIndex<1) nMenuIndex = 4;  //暂时不要密码设置，最大值为4，如果密码设置，则最大值为5
                bRefreshInterface = 1;
            }
            if(bRefreshInterface)
            {
                if(nMenuIndex < 5)  //显示第1-4项
                {
                    LcmSetSongBuff(20,21,22,23,0,0,0,0); //运行参数
                    if(nMenuIndex == 1)LcmPutSongStr(0,0,BuffCharDot,4,1); else  LcmPutSongStr(0,0,BuffCharDot,4,0);     
                    
                    LcmSetSongBuff(4,24,22,23,0,0,0,0); //用户参数
                    if(nMenuIndex == 2)LcmPutSongStr(2,0,BuffCharDot,4,1); else  LcmPutSongStr(2,0,BuffCharDot,4,0);    
                    
                    LcmSetSongBuff(25,26,22,23,0,0,0,0); //厂家参数
                    if(nMenuIndex == 3)LcmPutSongStr(4,0,BuffCharDot,4,1); else  LcmPutSongStr(4,0,BuffCharDot,4,0);    
                    
                    LcmSetSongBuff(27,28,22,23,0,0,0,0); //调整参数
                    if(nMenuIndex == 4)LcmPutSongStr(6,0,BuffCharDot,4,1); else  LcmPutSongStr(6,0,BuffCharDot,4,0);    
                }
                else  //显示第5项
                {
                    LcmClear(0x00);
                    LcmSetSongBuff(40,41,13,70,0,0,0,0); //密码设置
                    LcmPutSongStr(0,0,BuffCharDot,4,1);
                }
            }
            break;
        case INTERFACE_RUNPARAM:
            if(Key_Release(KEY_DOWN))
            {
                nParamIndex++;
                if(nParamIndex> 5) nParamIndex = 1;
                bRefreshInterface = 1;
            }
            else if(Key_Release(KEY_UP))
            {
                nParamIndex--;
                if(nParamIndex<1) nParamIndex = 5;
                bRefreshInterface = 1;
            }
            if(bRefreshInterface)
            {
                LcmClear(0x00);
                switch(nParamIndex)
                {
                    case 1:
                        LcmSetSongBuff(29,9,79,80,0,0,0,0); //主机电流
                        LcmPutSongStr(0,0,BuffCharDot,4,0);
                        LcmPutStr(0,2,(unsigned char *)"(A):");
                        LcmPutStr(0,4,(unsigned char *)"(B):");
                        LcmPutStr(0,6,(unsigned char *)"(C):");
                        LcmPutChar(80,2,'A');
                        LcmPutChar(80,4,'A');
                        LcmPutChar(80,6,'A');
                        break;
                    case 2:
                        LcmSetSongBuff(7,56,0,0,0,0,0,0); //压力
                        LcmPutSongStr(1,0,BuffCharDot,2,0);
                        LcmPutStr(96,4,(unsigned char *)"MPa");
                        
                        break;
                    case 3:
                        LcmSetSongBuff(20,21,87,33,34,0,0,0); //运行总时间
                        LcmPutSongStr(1,0,BuffCharDot,5,0);
                        
                        LcmSetSongBuff(119,33,0,0,0,0,0,0); //小时
                        LcmPutSongStr(4,96,BuffCharDot,2,0);
                        
                        break;

                    case 4:
                        
                        LcmSetSongBuff(88,36,87,33,34,0,0,0); //负载总时间
                        LcmPutSongStr(1,0,BuffCharDot,5,0);
                        
                        LcmSetSongBuff(119,33,0,0,0,0,0,0); //小时
                        LcmPutSongStr(4,96,BuffCharDot,2,0);                        
                        break;
                    case 5:
                        
                        LcmSetSongBuff(83,79,79,7,0,0,0,0); //供电电压
                        LcmPutSongStr(1,0,BuffCharDot,4,0);
                        
                        LcmPutStr(96,4,(unsigned char *) "V");                        
                        break;
                    default:
                        break;
                }
                //下面是显示当前运行状态数据，在主程序中每隔1秒会调用
                KYJ_ShowRunParam();
            }
            break;
        case INTERFACE_USERPARAM:  //用户参数
            if(Key_Release(KEY_DOWN))
            {
                nParamIndex++;
                if(nParamIndex> 12) nParamIndex = 1;
                bRefreshInterface = 1;
            }
            else if(Key_Release(KEY_UP))
            {
                nParamIndex--;
                if(nParamIndex<1) nParamIndex = 12;
                bRefreshInterface = 1;
            }
            if(bRefreshInterface)
            {
                LcmClear(0x00);
                KYJ_ShowUserParam(nParamIndex);
            }             
            break;
        case INTERFACE_FACTORYPARAM:
            if(Key_Release(KEY_DOWN))
            {
                nParamIndex++;
                if(nParamIndex> 10) nParamIndex = 1;
                bRefreshInterface = 1;
            }
            else if(Key_Release(KEY_UP))
            {
                nParamIndex--;
                if(nParamIndex<1) nParamIndex = 10;
                bRefreshInterface = 1;
            }
            if(bRefreshInterface)
            {
                LcmClear(0x00);
                KYJ_ShowFactoryParam(nParamIndex);
            }              
            break;
        case INTERFACE_REGPARAM:
            if(Key_Release(KEY_DOWN))
            {
                nParamIndex++;
                if(nParamIndex> 6) nParamIndex = 1;
                bRefreshInterface = 1;
            }
            else if(Key_Release(KEY_UP))
            {
                nParamIndex--;
                if(nParamIndex<1) nParamIndex = 6;
                bRefreshInterface = 1;
            }
            if(bRefreshInterface)
            {
                LcmClear(0x00);
                KYJ_ShowRegParam(nParamIndex);
            }            
            break;
        case INTERFACE_PASSWORD:
            break;
        case INTERFACE_PARAM:
            if((nMenuIndex==2 && sKYJ.nUserPass != sKYJ.sPassword.nUserPass)
                    ||((nMenuIndex==3 || nMenuIndex==4) && sKYJ.nFactoryPass != sKYJ.sPassword.nFactoryPass))
            {
                tempValue[3] = nPassValue/1000;
                tempValue[2] = (nPassValue - tempValue[3]*1000)/100;
                tempValue[1] = (nPassValue - tempValue[3]*1000-tempValue[2]*100)/10;
                tempValue[0] = nPassValue%10;
                if(Key_Release(KEY_DOWN))
                {
                    if(tempValue[nDigitIndex-1]==0) 
                        tempValue[nDigitIndex-1]=10;
                    tempValue[nDigitIndex-1]--;
                }
                else if(Key_Release(KEY_UP))
                {
                    tempValue[nDigitIndex-1]++;
                    if(tempValue[nDigitIndex-1]>9)tempValue[nDigitIndex-1]=0;
                }
                else if(Key_Release(KEY_MOVE))
                {
                    nDigitIndex++;
                    if(nDigitIndex>4)nDigitIndex = 1;
                }
                nPassValue = tempValue[3]*1000 + tempValue[2]*100 + tempValue[1]*10 + tempValue[0];
                LcmPutFixDigit(4,40,nPassValue,4,nDigitIndex);
                if(Key_Release(KEY_OK))
                {
                    nDigitIndex = 1;
                    if(nMenuIndex == 2)
                    {
                        sKYJ.nUserPass = nPassValue;
                        if(sKYJ.nUserPass == sKYJ.sPassword.nUserPass)
                        {
                            LcmClear(0);
                            KYJ_ShowUserParam(nParamIndex);
                        }
                    }
                    else if(nMenuIndex == 3)
                    {
                        sKYJ.nFactoryPass = nPassValue;
                        if(sKYJ.nFactoryPass == sKYJ.sPassword.nFactoryPass)
                        {
                            LcmClear(0);
                            KYJ_ShowFactoryParam(nParamIndex);
                        }
                    }
                    else if(nMenuIndex == 4 )
                    {
                        sKYJ.nFactoryPass = nPassValue;
                        if(sKYJ.nFactoryPass == sKYJ.sPassword.nFactoryPass)
                        {
                            LcmClear(0);
                            KYJ_ShowRegParam(nParamIndex);
                        }
                    }
                }                
            }
//            else if((nMenuIndex==3 || nMenuIndex==4) && sKYJ.nFactoryPass != sKYJ.sPassword.nFactoryPass)
//            {
//                tempValue[3] = sKYJ.nFactoryPass/1000;
//                tempValue[2] = (sKYJ.nFactoryPass - tempValue[3]*1000)/100;
//                tempValue[1] = (sKYJ.nFactoryPass - tempValue[3]*1000-tempValue[2]*100)/10;
//                tempValue[0] = sKYJ.nFactoryPass%10;
//                if(Key_Release(KEY_DOWN))
//                {
//                    if(tempValue[nDigitIndex-1]==0) 
//                        tempValue[nDigitIndex-1]=10;
//                    tempValue[nDigitIndex-1]--;
//                }
//                else if(Key_Release(KEY_UP))
//                {
//                    tempValue[nDigitIndex-1]++;
//                    if(tempValue[nDigitIndex-1]>9)tempValue[nDigitIndex-1]=0;
//                }
//                else if(Key_Release(KEY_MOVE))
//                {
//                    nDigitIndex++;
//                    if(nDigitIndex>4)nDigitIndex = 1;
//                }
//                LcmPutFixDigit(4,40,tempValue[3]*1000 + tempValue[2]*100 + tempValue[1]*10 + tempValue[0],4,nDigitIndex);
//                if(Key_Release(KEY_OK))
//                {
//                    sKYJ.nFactoryPass = tempValue[3]*1000 + tempValue[2]*100 + tempValue[1]*10 + tempValue[0];
//                    nDigitIndex = 1;
//                }                  
//            }
            else
            {
                tempValue[3] = nParamValue/1000;
                tempValue[2] = (nParamValue - tempValue[3]*1000)/100;
                tempValue[1] = (nParamValue - tempValue[3]*1000-tempValue[2]*100)/10;
                tempValue[0] = nParamValue%10;

                if(Key_Release(KEY_DOWN))
                {

                    if(tempValue[nDigitIndex-1]==0) 
                        tempValue[nDigitIndex-1]=10;
                    tempValue[nDigitIndex-1]--;
                }
                else if(Key_Release(KEY_UP))
                {
                    tempValue[nDigitIndex-1]++;
                    if(tempValue[nDigitIndex-1]>9)tempValue[nDigitIndex-1]=0;
                }
                else if(Key_Release(KEY_MOVE))
                {
                    nDigitIndex++;
                    if(nDigitIndex>4)nDigitIndex = 1;
                }
    //            else if(Key_Release(KEY_OK))
    //            {
    //                KYJ_EnterParamValue(nMenuIndex,nParamIndex,nParamValue);
    //            }
                nParamValue = tempValue[3]*1000 + tempValue[2]*100 + tempValue[1]*10 + tempValue[0];
                if(nMenuIndex == 2 && (nParamIndex==8 || nParamIndex == 9))
                    LcmPutFloatDigit(4,40,nParamValue,4,nDigitIndex,2);
                else if(nMenuIndex == 2 && nParamIndex == 10) //启动方式
                {
                    nDigitIndex = 1;
                    if(nParamValue>0)nParamValue = 1;
                    LcmPutFixDigit(4,40,nParamValue,1,nDigitIndex);
                    if(nParamValue == 0)
                        LcmSetSongBuff(122,123,31,32,0,0,0,0); //直接启动
                    else
                        LcmSetSongBuff(120,121,31,32,0,0,0,0); //星角启动
                    LcmPutSongStr(4,60,BuffCharDot,4,0);                
                }
                else if(nMenuIndex == 3 && (nParamIndex==1 || nParamIndex==9))
                    LcmPutFloatDigit(4,40,nParamValue,4,nDigitIndex,1);
                else if(nMenuIndex == 3 && (nParamIndex == 4 || nParamIndex == 5))
                    LcmPutFloatDigit(4,40,nParamValue,4,nDigitIndex,2);
                else if(nMenuIndex == 4 && (nParamIndex == 1 || nParamIndex == 2|| nParamIndex ==3))
                    LcmPutFloatDigit(0,87,nParamValue,4,nDigitIndex,1);
                else if(nMenuIndex == 4 && nParamIndex==4)
                    LcmPutFixDigit(3,87,nParamValue,4,nDigitIndex);
                else if(nMenuIndex == 4 && nParamIndex==5)
                    LcmPutFixDigit(0,87,nParamValue,4,nDigitIndex);
                else if(nMenuIndex == 4 && nParamIndex==6)
                    LcmPutFixDigit(0,87,nParamValue,4,nDigitIndex);
                else
                    LcmPutFixDigit(4,40,nParamValue,4,nDigitIndex);
                if(Key_Release(KEY_OK))
                {
                    KYJ_EnterParamValue(nMenuIndex,nParamIndex,nParamValue);
                }
            }
            break;
        default:
            break;
    }
    
    bRefreshInterface = 0;
    return;      
}

void KYJ_ShowUserParam(unsigned char nParamIndex)
{
                switch(nParamIndex)
                {
                    case 1:
                        LcmSetSongBuff(42,9,31,32,10,11,0,0); //风机启动温度
                        LcmPutSongStr(1,0,BuffCharDot,6,0);
                        nParamValue = sKYJ.sUserParam.nFanStartTemp;
                        LcmPutFixDigit(4,40,nParamValue,4,0);
                        LcmSetSongBuff(12,0,0,0,0,0,0,0); //℃
                        LcmPutSongStr(4,96,BuffCharDot,1,0);
                        break;
                    case 2:
                        LcmSetSongBuff(42,9,17,18,10,11,0,0); //风机停止温度
                        LcmPutSongStr(1,0,BuffCharDot,6,0);
                        nParamValue = sKYJ.sUserParam.nFanStopTemp;
                        LcmPutFixDigit(4,40,nParamValue,4,0);
                        LcmSetSongBuff(12,0,0,0,0,0,0,0); //℃
                        LcmPutSongStr(4,96,BuffCharDot,1,0);
                        
                        break;
                    case 3:
                        LcmSetSongBuff(29,9,37,33,33,34,0,0); //主机延时时间
                        LcmPutSongStr(1,0,BuffCharDot,6,0);
                        nParamValue = sKYJ.sUserParam.nMCUDelayTime;
                        LcmPutFixDigit(4,40,nParamValue,4,0);
                        LcmSetSongBuff(19,0,0,0,0,0,0,0); //秒
                        LcmPutSongStr(4,96,BuffCharDot,1,0);
                        
                        break;

                    case 4:
                        LcmSetSongBuff(35,36,37,33,33,34,0,0); //加载延时时间
                        LcmPutSongStr(1,0,BuffCharDot,6,0);
                        nParamValue = sKYJ.sUserParam.nLoadDelayTime;
                        LcmPutFixDigit(4,40,nParamValue,4,0);
                        LcmSetSongBuff(19,0,0,0,0,0,0,0); //秒
                        LcmPutSongStr(4,96,BuffCharDot,1,0);                        
                        break;
                    case 5:
                        LcmSetSongBuff(43,36,37,33,33,34,0,0); //空载延时时间
                        LcmPutSongStr(1,0,BuffCharDot,6,0);
                        nParamValue = sKYJ.sUserParam.nNoLoadDelayTime;
                        LcmPutFixDigit(4,40,nParamValue,4,0);
                        LcmSetSongBuff(19,0,0,0,0,0,0,0); //秒
                        LcmPutSongStr(4,96,BuffCharDot,1,0);                        
                        break;
                    case 6:
                        LcmSetSongBuff(17,9,37,33,33,34,0,0); //停机延时时间
                        LcmPutSongStr(1,0,BuffCharDot,6,0);
                        nParamValue = sKYJ.sUserParam.nStopDelayTime;
                        LcmPutFixDigit(4,40,nParamValue,4,0);
                        LcmSetSongBuff(19,0,0,0,0,0,0,0); //秒
                        LcmPutSongStr(4,96,BuffCharDot,1,0);                        
                        break;
                    case 7:
                        LcmSetSongBuff(44,31,37,33,33,34,0,0); //重启延时时间
                        LcmPutSongStr(1,0,BuffCharDot,6,0);
                        nParamValue = sKYJ.sUserParam.nRestartDelayTime;
                        LcmPutFixDigit(4,40,nParamValue,4,0);
                        LcmSetSongBuff(19,0,0,0,0,0,0,0); //秒
                        LcmPutSongStr(4,96,BuffCharDot,1,0);                        
                        break;
                    case 8:
                        LcmSetSongBuff(35,36,7,56,0,0,0,0); //加载压力
                        LcmPutSongStr(1,0,BuffCharDot,4,0);
                        nParamValue = sKYJ.sUserParam.nLoadPress;
                        //LcmPutFixDigit(4,40,nParamValue,4,0);
                        LcmPutFloatDigit(4,40,nParamValue,4,0,2);
                        //LcmSetSongBuff(19,0,0,0,0,0,0,0); //秒
                        //LcmPutSongStr(4,96,BuffCharDot,1,0); 
                        LcmPutStr(96,4,(unsigned char *)"MPa");
                        break;
                    case 9:
                         LcmSetSongBuff(57,36,7,56,0,0,0,0); //卸载压力
                        LcmPutSongStr(1,0,BuffCharDot,4,0);
                        nParamValue = sKYJ.sUserParam.nUnLoadPress;
                        //LcmPutFixDigit(4,40,nParamValue,4,0);
                        LcmPutFloatDigit(4,40,nParamValue,4,0,2);
                        //LcmSetSongBuff(19,0,0,0,0,0,0,0); //秒
                        //LcmPutSongStr(4,96,BuffCharDot,1,0);
                        LcmPutStr(96,4,(unsigned char *)"MPa");
                        break;
                    case 10:
                        LcmSetSongBuff(31,32,45,46,0,0,0,0);//启动方式
                        LcmPutSongStr(1,0,BuffCharDot,4,0);
                        nParamValue = sKYJ.sFactoryParam.nStartType;
                        LcmPutFixDigit(4,40,nParamValue,1,0);
                        if(nParamValue == 0)
                            LcmSetSongBuff(122,123,31,32,0,0,0,0); //直接启动
                        else
                            LcmSetSongBuff(120,121,31,32,0,0,0,0); //星角启动
                        LcmPutSongStr(4,60,BuffCharDot,4,0);
                        break;
                    case 11:
                        LcmSetSongBuff(120,121,37,33,33,34,0,0);//星角延时时间
                        LcmPutSongStr(1,0,BuffCharDot,6,0);
                        nParamValue = sKYJ.sUserParam.nSADelayTime;
                        LcmPutFixDigit(4,40,nParamValue,4,0);
                        LcmSetSongBuff(19,0,0,0,0,0,0,0); //秒
                        LcmPutSongStr(4,96,BuffCharDot,1,0);
                        break;
                    case 12:
                        LcmSetSongBuff(75,76,4,24,40,41,0,0);//用户密码
                        LcmPutSongStr(1,0,BuffCharDot,6,0);
                        nParamValue = sKYJ.sPassword.nUserPass;
                        if(sKYJ.nUserPass == sKYJ.sPassword.nUserPass)
                            LcmPutFixDigit(4,40,nParamValue,4,0);
                        else
                            LcmPutStr(40,4,(unsigned char *)"****");
                        break;                        
                    default:
                        break;
                }    
}

void KYJ_ShowFactoryParam(unsigned char nParamIndex)  //显示厂家参数
{
                switch(nParamIndex)
                {
                    case 1:
                        LcmSetSongBuff(29,9,77,78,79,80,0,0); //主机额定电流
                        LcmPutSongStr(1,0,BuffCharDot,6,0);
                        nParamValue = sKYJ.sFactoryParam.nMainMotorNormalCurrent;
                        //LcmPutFixDigit(4,40,nParamValue,4,0);
                        LcmPutFloatDigit(4,40,nParamValue,4,0,1);
//                        LcmSetSongBuff(12,0,0,0,0,0,0,0); //℃
//                        LcmPutSongStr(4,96,BuffCharDot,1,0);
                        LcmPutChar(96,4,'A');
                        break;
                    case 2:
                        LcmSetSongBuff(81,10,69,82,10,11,0,0); //排温预警温度
                        LcmPutSongStr(1,0,BuffCharDot,6,0);
                        nParamValue = sKYJ.sFactoryParam.nWarningTemp;
                        LcmPutFixDigit(4,40,nParamValue,4,0);
                        LcmSetSongBuff(12,0,0,0,0,0,0,0); //℃
                        LcmPutSongStr(4,96,BuffCharDot,1,0);
                        
                        break;
                    case 3:
                        LcmSetSongBuff(81,10,17,9,10,11,0,0); //排温停机温度
                        LcmPutSongStr(1,0,BuffCharDot,6,0);
                        nParamValue = sKYJ.sFactoryParam.nStopTemp;
                        LcmPutFixDigit(4,40,nParamValue,4,0);
                        LcmSetSongBuff(12,0,0,0,0,0,0,0); //℃
                        LcmPutSongStr(4,96,BuffCharDot,1,0);
                        
                        break;

                    case 4:
                        LcmSetSongBuff(83,84,17,9,7,56,0,0); //供气停机压力
                        LcmPutSongStr(1,0,BuffCharDot,6,0);
                        nParamValue = sKYJ.sFactoryParam.nStopPress;
                        //LcmPutFixDigit(4,40,nParamValue,4,0);
                        LcmPutFloatDigit(4,40,nParamValue,4,0,2);
//                        LcmSetSongBuff(12,0,0,0,0,0,0,0); //℃
//                        LcmPutSongStr(4,96,BuffCharDot,1,0);      
                        LcmPutStr(96,4,(unsigned char *)"MPa");
                        break;
                    case 5:
                        LcmSetSongBuff(57,36,7,56,85,86,0,0); //卸载压力高限
                        LcmPutSongStr(1,0,BuffCharDot,6,0);
                        nParamValue = sKYJ.sFactoryParam.nUnloadPressLimit;
                        //LcmPutFixDigit(4,40,nParamValue,4,0);
                        LcmPutFloatDigit(4,40,nParamValue,4,0,2);
//                        LcmSetSongBuff(12,0,0,0,0,0,0,0); //℃
//                        LcmPutSongStr(4,96,BuffCharDot,1,0);      
                        LcmPutStr(96,4,(unsigned char *)"MPa");                        
                        break;
                    case 6:
                        LcmSetSongBuff(20,21,87,33,34,0,0,0); //运行总时间
                        LcmPutSongStr(1,0,BuffCharDot,5,0);
                        sKYJ.sRunParam.nTotalTime = sKYJ.sFactoryParam.nTotalRunTime / 60;
                        LcmPutFixDigit(4,8,sKYJ.sRunParam.nTotalTime/10000,4,0);
                        //LcmPutFixDigit(4,40,sKYJ.sRunParam.nTotalTime%10000,4,0);
                        nParamValue = sKYJ.sRunParam.nTotalTime%10000;
                        LcmPutFixDigit(4,40,nParamValue,4,0);
                        LcmSetSongBuff(119,33,0,0,0,0,0,0); //小时
                        LcmPutSongStr(4,96,BuffCharDot,2,0);                          
                        break;
                    case 7:
                        LcmSetSongBuff(88,36,87,33,34,0,0,0); //负载总时间
                        LcmPutSongStr(1,0,BuffCharDot,5,0);
                        sKYJ.sRunParam.nLoadTime = sKYJ.sFactoryParam.nTotalLoadTime / 60;
                        LcmPutFixDigit(4,8,sKYJ.sRunParam.nLoadTime/10000,4,0);
                        nParamValue = sKYJ.sRunParam.nLoadTime%10000;
                        LcmPutFixDigit(4,40,nParamValue,4,0);
                        LcmSetSongBuff(119,33,0,0,0,0,0,0); //小时
                        LcmPutSongStr(4,96,BuffCharDot,2,0);                          
                        break;
                    case 8:
                        LcmSetSongBuff(109,10,98,99,0,0,0,0); //低温保护
                        LcmPutSongStr(1,0,BuffCharDot,4,0);
                        nParamValue = sKYJ.sFactoryParam.nLowTempProtect;
                        LcmPutChar(32,4,'-');
                        LcmPutFixDigit(4,40,nParamValue,4,0);
                        LcmSetSongBuff(12,0,0,0,0,0,0,0); //℃
                        LcmPutSongStr(4,96,BuffCharDot,1,0); 
                        break;
                    case 9:
//                        LcmSetSongBuff(33,86,0,0,0,0,0,0); //时限
//                        LcmPutSongStr(1,0,BuffCharDot,2,0);
//                        nParamValue = sKYJ.sFactoryParam.nTimeLimit;
//                        LcmPutFixDigit(4,40,nParamValue,4,0);
//                        LcmSetSongBuff(119,33,0,0,0,0,0,0); //时
//                        LcmPutSongStr(4,96,BuffCharDot,2,0);
                        LcmSetSongBuff(79,80,93,94,95,11,0,0); //电流不平衡度
                        LcmPutSongStr(1,0,BuffCharDot,6,0);
                        nParamValue = sKYJ.sFactoryParam.nCurrentNotBalance;
                        LcmPutFloatDigit(4,40,nParamValue,4,0,1);
                        break;       
                    case 10:
                        LcmSetSongBuff(75,76,25,26,40,41,0,0);//修改厂家密码
                        LcmPutSongStr(1,0,BuffCharDot,6,0);
                        nParamValue = sKYJ.sPassword.nFactoryPass;
                        if(sKYJ.nFactoryPass == sKYJ.sPassword.nFactoryPass)
                            LcmPutFixDigit(4,40,nParamValue,4,0);
                        else
                            LcmPutStr(40,4,(unsigned char *)"****");
                    default:
                        break;
                }    
}
void KYJ_ShowRegParam(unsigned char nParamIndex)
{
                switch(nParamIndex)
                {
                    case 1:
                        LcmSetSongBuff(113,114,79,80,0,0,0,0); //标准电流
                        LcmPutSongStr(0,0,BuffCharDot,4,0);
                        LcmPutStr(64,0,(unsigned char *)"A");
                        nParamValue = sKYJ.sRegParam.nStandCurrentA;
                        LcmPutFloatDigit(0,87,nParamValue,4,0,1);
                        
                        LcmSetSongBuff(115,23,0,0,0,0,0,0); //系数
                        LcmPutSongStr(3,0,BuffCharDot,2,0);
                        LcmPutStr(32,3,(unsigned char *)"A");
                        LcmPutFloatDigit(3,87,sKYJ.sRegParam.nStandCurrentAFactor,4,0,3);
                        
                        LcmSetSongBuff(116,21,79,80,0,0,0,0); //现行电流
                        LcmPutSongStr(6,0,BuffCharDot,4,0);
                        LcmPutStr(64,6,(unsigned char *)"A");
                        //nLongTemp = (unsigned long)sKYJ.sRunParam.nCurrentA*sKYJ.sRegParam.nStandCurrentAFactor;
                        //sKYJ.sRegParam.nCurrentA = nLongTemp/1000;
                        sKYJ.sRegParam.nCurrentA = sKYJ.nCurrentA;
                        LcmPutFloatDigit(6,87,sKYJ.sRegParam.nCurrentA,4,0,1);
                        
                        break;
                    case 2:
                        LcmSetSongBuff(113,114,79,80,0,0,0,0); //标准电流
                        LcmPutSongStr(0,0,BuffCharDot,4,0);
                        LcmPutStr(64,0,(unsigned char *)"B");
                        nParamValue = sKYJ.sRegParam.nStandCurrentB;
                        LcmPutFloatDigit(0,87,nParamValue,4,0,1);
                        
                        LcmSetSongBuff(115,23,0,0,0,0,0,0); //系数
                        LcmPutSongStr(3,0,BuffCharDot,2,0);
                        LcmPutStr(32,3,(unsigned char *)"B");
                        LcmPutFloatDigit(3,87,sKYJ.sRegParam.nStandCurrentBFactor,4,0,3);
                        
                        LcmSetSongBuff(116,21,79,80,0,0,0,0); //现行电流
                        LcmPutSongStr(6,0,BuffCharDot,4,0);
                        LcmPutStr(64,6,(unsigned char *)"B");
                        //nLongTemp = (unsigned long)sKYJ.sRunParam.nCurrentB*sKYJ.sRegParam.nStandCurrentBFactor;
                        //sKYJ.sRegParam.nCurrentB = nLongTemp/1000;
                        sKYJ.sRegParam.nCurrentB = sKYJ.nCurrentB;
                        LcmPutFloatDigit(6,87,sKYJ.sRegParam.nCurrentB,4,0,1);
                        
                        break;
                    case 3:  
                        LcmSetSongBuff(113,114,79,80,0,0,0,0); //标准电流
                        LcmPutSongStr(0,0,BuffCharDot,4,0);
                        LcmPutStr(64,0,(unsigned char *)"C");
                        nParamValue = sKYJ.sRegParam.nStandCurrentC;
                        LcmPutFloatDigit(0,87,nParamValue,4,0,1);
                        
                        LcmSetSongBuff(115,23,0,0,0,0,0,0); //系数
                        LcmPutSongStr(3,0,BuffCharDot,2,0);
                        LcmPutStr(32,3,(unsigned char *)"C");
                        LcmPutFloatDigit(3,87,sKYJ.sRegParam.nStandCurrentCFactor,4,0,3);
                        
                        LcmSetSongBuff(116,21,79,80,0,0,0,0); //现行电流
                        LcmPutSongStr(6,0,BuffCharDot,4,0);
                        LcmPutStr(64,6,(unsigned char *)"C");
                        //nLongTemp = (unsigned long)sKYJ.sRunParam.nCurrentC*sKYJ.sRegParam.nStandCurrentCFactor;
                        //sKYJ.sRegParam.nCurrentC = nLongTemp/1000;
                        sKYJ.sRegParam.nCurrentC = sKYJ.nCurrentC;
                        LcmPutFloatDigit(6,87,sKYJ.sRegParam.nCurrentC,4,0,1);
                        break;

                    case 4: //调整零点
                        LcmSetSongBuff(113,114,10,11,0,0,0,0); //标准温度
                        LcmPutSongStr(0,0,BuffCharDot,4,0);
                        //LcmPutFixDigit(0,87,sKYJ.nTemperature,4,0);
                        LcmPutFixDigit(0,87,0,4,0);
                        
                        LcmSetSongBuff(117,118,0,0,0,0,0,0); //零点
                        LcmPutSongStr(3,0,BuffCharDot,2,0);
                        nParamValue = sKYJ.sRegParam.nZeroBias;
                        LcmPutFixDigit(3,87,sKYJ.sRegParam.nZeroBias,4,0);
                        
                        LcmSetSongBuff(116,21,10,11,0,0,0,0); //现行温度
                        LcmPutSongStr(6,0,BuffCharDot,4,0);
                        //sKYJ.sRegParam.nTemp = sKYJ.sRunParam.nTemperature;// - sKYJ.sRegParam.nZeroBias;
                        sKYJ.sRegParam.nTemp = sKYJ.nTemperature;
                        LcmPutFixDigit(6,87,sKYJ.sRegParam.nTemp,4,0);
                                            
                        break;
                    case 5: //调整温度系数
                        LcmSetSongBuff(113,114,10,11,0,0,0,0); //标准温度
                        LcmPutSongStr(0,0,BuffCharDot,4,0);
                        nParamValue = sKYJ.sRegParam.nStandTemp;
                        LcmPutFixDigit(0,87,nParamValue,4,0);
                        
                        LcmSetSongBuff(115,23,0,0,0,0,0,0); //系数
                        LcmPutSongStr(3,0,BuffCharDot,2,0);
                        LcmPutFloatDigit(3,87,sKYJ.sRegParam.nStandTempFactor,4,0,3);
                        
                        LcmSetSongBuff(116,21,10,11,0,0,0,0); //现行温度
                        LcmPutSongStr(6,0,BuffCharDot,4,0);
//                        nLongTemp = sKYJ.sRunParam.nTemperature - sKYJ.sRegParam.nZeroBias;
//                        nLongTemp = nLongTemp * sKYJ.sRegParam.nStandTempFactor/1000;
                        sKYJ.sRegParam.nTemp = sKYJ.nTemperature;
                        LcmPutFixDigit(6,87,sKYJ.sRegParam.nTemp,4,0);
                                            
                        break;
                    case 6: //调整电压系数
                        LcmSetSongBuff(113,114,79,7,0,0,0,0); //标准电压
                        LcmPutSongStr(0,0,BuffCharDot,4,0);
                        nParamValue = sKYJ.sRegParam.nStandVoltage;
                        LcmPutFixDigit(0,87,nParamValue,4,0);
                        
                        LcmSetSongBuff(115,23,0,0,0,0,0,0); //系数
                        LcmPutSongStr(3,0,BuffCharDot,2,0);
                        LcmPutFloatDigit(3,87,sKYJ.sRegParam.nStandVoltageFactor,4,0,3);
                        
                        LcmSetSongBuff(116,21,79,7,0,0,0,0); //现行电压
                        LcmPutSongStr(6,0,BuffCharDot,4,0);
                        sKYJ.sRegParam.nVoltage = sKYJ.nVoltage;
                        LcmPutFixDigit(6,87,sKYJ.sRegParam.nVoltage,4,0);
                                            
                        break;
                    default:
                        break;
                }    
}
void KYJ_EnterParamValue(unsigned char nMI,unsigned char nPI, int nValue)
{
    
    if(nMI == 2)//用户参数
    {
        switch(nPI)
        {
            case 1:
               sKYJ.sUserParam.nFanStartTemp = nValue;
                break;
            case 2:
                sKYJ.sUserParam.nFanStopTemp  = nValue;
                break;
            case 3:
                sKYJ.sUserParam.nMCUDelayTime = nValue;
                break;
            case 4:
                sKYJ.sUserParam.nLoadDelayTime = nValue;
                break;
            case 5:
                sKYJ.sUserParam.nNoLoadDelayTime = nValue;
                break;
            case 6:
                sKYJ.sUserParam.nStopDelayTime  = nValue;
                break;
            case 7:
                sKYJ.sUserParam.nRestartDelayTime = nValue;
                break;
            case 8:
                sKYJ.sUserParam.nLoadPress = nValue;
                break;
            case 9:
                sKYJ.sUserParam.nUnLoadPress = nValue;
                break;
            case 10: //保存启动方式，0直接启动，非0则为星角启动
                (nValue == 0) ? sKYJ.sFactoryParam.nStartType = 0 : sKYJ.sFactoryParam.nStartType=1;
                break;
            case 11:
                sKYJ.sUserParam.nSADelayTime = nValue;
                break;
            case 12:
                sKYJ.sPassword.nUserPass = nValue;
                break;
            default:
                break;            
        }
        KYJ_SwitchToInterface(INTERFACE_USERPARAM);
        KYJ_ShowUserParam(nPI);
    }
    else if(nMI == 3) //厂家参数
    {
                switch(nPI)
                {
                    case 1:
                        sKYJ.sFactoryParam.nMainMotorNormalCurrent = nValue;
                        break;
                    case 2:
                        sKYJ.sFactoryParam.nWarningTemp=nValue;
                        break;
                    case 3:
                        sKYJ.sFactoryParam.nStopTemp = nValue;
                        break;

                    case 4:
                        sKYJ.sFactoryParam.nStopPress = nValue;
                        break;
                    case 5:
                        sKYJ.sFactoryParam.nUnloadPressLimit=nValue;
                        break;
                    case 6:
                        sKYJ.sFactoryParam.nTotalRunTime = (unsigned long)nValue*60;
                        break;
                    case 7:
                        sKYJ.sFactoryParam.nTotalLoadTime = (unsigned long)nValue*60;
                        break;
                    case 8:
                        sKYJ.sFactoryParam.nLowTempProtect = nValue;
                        break;
                    case 9:
                        //sKYJ.sFactoryParam.nTimeLimit = nValue;
                        sKYJ.sFactoryParam.nCurrentNotBalance = nValue;
                        break;
                    case 10:
                        sKYJ.sPassword.nFactoryPass = nValue;
                        break;
                    default:
                        break;
                }        
        KYJ_SwitchToInterface(INTERFACE_FACTORYPARAM);
        KYJ_ShowFactoryParam(nPI);
    }
    else if(nMI == 4) //调整参数
    {
        switch(nPI)
        {
            case 1:
                sKYJ.sRegParam.nStandCurrentA = nParamValue;
                nLongTemp = (unsigned long)sKYJ.sRegParam.nStandCurrentA * 1000;
                sKYJ.sRegParam.nStandCurrentAFactor = nLongTemp/sKYJ.sRunParam.nCurrentA;
                
                break;
            case 2:
                sKYJ.sRegParam.nStandCurrentB = nParamValue;
                nLongTemp = (unsigned long)sKYJ.sRegParam.nStandCurrentB * 1000;
                sKYJ.sRegParam.nStandCurrentBFactor = nLongTemp/sKYJ.sRunParam.nCurrentB;
                break;
            case 3:
                sKYJ.sRegParam.nStandCurrentC = nParamValue;
                nLongTemp = (unsigned long)sKYJ.sRegParam.nStandCurrentC * 1000;
                sKYJ.sRegParam.nStandCurrentCFactor = nLongTemp/sKYJ.sRunParam.nCurrentC;
                break;
            case 4:
                sKYJ.sRegParam.nZeroBias = nParamValue;
                break;
            case 5:
                sKYJ.sRegParam.nStandTemp = nParamValue;
                sKYJ.sRegParam.nStandTempFactor = (long)nParamValue *1000/(sKYJ.sRunParam.nTemperature - sKYJ.sRegParam.nZeroBias) ;
            case 6:
                sKYJ.sRegParam.nStandVoltage = nParamValue;
                sKYJ.sRegParam.nStandVoltageFactor = (long)nParamValue * 1000/sKYJ.sRunParam.nVoltage;
            default:
               ;
        }
        KYJ_SwitchToInterface(INTERFACE_REGPARAM);
        KYJ_ShowRegParam(nParamIndex);
    }
    else if(nMI == 5) //密码设置
    {
        KYJ_SwitchToInterface(INTERFACE_PASSWORD);
    }
    sKYJ.nValidateParamResult = KYJ_ValidateParam(); //保存数据前先验证下，否则不保存
    if(sKYJ.nValidateParamResult == 0)
        EEPROM_Save_Param(PARAM_STORE_BYTES);
}

void KYJ_UpdateData(void)  //更新压力、温度、电流
{
    //更新压力
    //nSampleValue = (int)(adc_Get_Value(CH_Pressure)*4*0.1*100/220.0-40);
    nSampleValue = adc_Get_Value(CH_Pressure);
//    nSampleValue = adc_Get_Value(CH_Temperature);
    nLongTemp = (long) nSampleValue * nADVref * 100;
    nSampleValue = nLongTemp /(220*1024) - 40;  //压力计算公式：(sample/1024 * nADVref (mV) / 220 欧  - 4mA) * 0.1MPa/mA *100 倍数
    sKYJ.sRunParam.nPressure = nSampleValue;  //压力=nSampleValue * 0.01MPa，如果是负值，很可能是没有接压力传感器，连4mA的电流都没有。
//    if(nSampleValue > 0)
//        sKYJ.nPressure = sKYJ.sRunParam.nPressure;  //压力显示值
    //更新温度
    nSampleValue = adc_Get_Value(CH_Temperature)*15/10;

    nLongTemp = (long)nSampleValue*5000*100;
    nSampleValue = nLongTemp/(21000-nSampleValue);  //得到电阻值，单位：0.01欧
    nLongTemp = (long)(nSampleValue - 10000) * 150 * 10 / 5700; 
    sKYJ.sRunParam.nTemperature = nLongTemp; //计算得到温度值，0.1度
    sKYJ.nTemperature = sKYJ.sRunParam.nTemperature/10;   //显示温度值

    //更新电源电压，RB3
    nSampleValue = adc_Get_Value(CH_Power);
   
    nLongTemp = (long)nSampleValue * nADVref * 6;  //采样电阻分压比5.5454：1，变压器变比11：1
    sKYJ.sRunParam.nVoltage = nLongTemp /102400; //假设电源电压到AD前的电压比是100：1
    
    KYJ_CalcRegValue();
}

void KYJ_SampleCurrent(void)  //在定时中断中1ms调用一次
{
    nCurrentSampleCount++;
    if(nCurrentSampleCount<20)  //1-19次采样A相
    {
        //取最大值
//        nSampleValue = adc_Get_Value(CH_CurrentA);
//        if(nSampleValue > nCurrent) nCurrent = nSampleValue;
        //取平均值
        nCurrent+=adc_Get_Value(CH_CurrentA);
    }
    else if(nCurrentSampleCount == 20) //第20次采样后，计算A相平均采样值
    {
        //取最大值
//        nSampleValue = adc_Get_Value(CH_CurrentA);
//        if(nSampleValue > nCurrent) nCurrent = nSampleValue;
        //取平均值
        nCurrent+=adc_Get_Value(CH_CurrentA);
        nCurrent = nCurrent / 10;
 
//这个可能溢出
//        nLongTemp = nCurrent * nADVref * CURRENT_TRANS_RATIO;
//        sKYJ.sRunParam.nCurrentA = nLongTemp/(1024*100*CURRENT_SAMPLE_RES);   //计算A相的平均值，因为半波检流，所以除以20在乘以2；
        
        nLongTemp = nCurrent * 5 * CURRENT_TRANS_RATIO;
        sKYJ.sRunParam.nCurrentA = nLongTemp/(102*CURRENT_SAMPLE_RES);   //计算A相电流，*5 参考电压5伏，/102，也就是1024，因为单位0.1A，也就是放大10倍

         nCurrent=0;
    }
    else if(nCurrentSampleCount < 40) //第21-39次采样B相
    {
        nCurrent+=adc_Get_Value(CH_CurrentB);
//        nSampleValue = adc_Get_Value(CH_CurrentB);
//        if(nSampleValue > nCurrent) nCurrent = nSampleValue;
    }
    else if(nCurrentSampleCount == 40) //第40次采样B相后，计算B相采样平均值
    {
        nCurrent+=adc_Get_Value(CH_CurrentB);
        nCurrent = nCurrent /10;
//        nSampleValue = adc_Get_Value(CH_CurrentB);
//        if(nSampleValue > nCurrent) nCurrent = nSampleValue;
//        nLongTemp = nCurrent * nADVref * CURRENT_TRANS_RATIO;
//        sKYJ.sRunParam.nCurrentB = nLongTemp/(1024*100*CURRENT_SAMPLE_RES); 
        nLongTemp = nCurrent * 5 * CURRENT_TRANS_RATIO;
        sKYJ.sRunParam.nCurrentB = nLongTemp/(102*CURRENT_SAMPLE_RES);   //计算B相电流，*5 参考电压5伏，/102，也就是1024，因为单位0.1A，也就是放大10倍
        
        nCurrent=0;
    }
    else if(nCurrentSampleCount <60) //第41-59次采样C相
    {
        nCurrent+=adc_Get_Value(CH_CurrentC);
//        nSampleValue = adc_Get_Value(CH_CurrentC);
//        if(nSampleValue > nCurrent) nCurrent = nSampleValue;
    }
    else if(nCurrentSampleCount == 60)  //第60次采样C相后，计算C相平均采样值
    {
        nCurrent+=adc_Get_Value(CH_CurrentC);
        nCurrent = nCurrent /10;
//        nSampleValue = adc_Get_Value(CH_CurrentC);
//        if(nSampleValue > nCurrent) nCurrent = nSampleValue;
//        nLongTemp = nCurrent * nADVref * CURRENT_TRANS_RATIO;
//        sKYJ.sRunParam.nCurrentC = nLongTemp/(1024*100*CURRENT_SAMPLE_RES); 
        nLongTemp = nCurrent * 5 * CURRENT_TRANS_RATIO;
        sKYJ.sRunParam.nCurrentC = nLongTemp/(102*CURRENT_SAMPLE_RES);   //计算C相电流，*5 参考电压5伏，/102，也就是1024，因为单位0.1A，也就是放大10倍  
        
        nCurrent=0;
        //nCurrentSampleCount = 0;
    }
    else if(nCurrentSampleCount <70)
    {
        nCurrent+=adc_Get_Value(CH_Pressure);
    }
    else if(nCurrentSampleCount == 70)
    {
        //更新压力
        nCurrent+=adc_Get_Value(CH_Pressure);
        nSampleValue = nCurrent / 10;
        //测试用
        //nSampleValue = 600;

//        nSampleValue = adc_Get_Value(CH_Pressure);
//        nLongTemp = (long) nSampleValue * nADVref * 10;

        
//        nSampleValue = adc_Get_Value(CH_Temperature)*15/10;  //测试用
//        nLongTemp = (long) nSampleValue * nADVref;  //测试用
        nLongTemp = (long)nSampleValue * nADVref;
        nLongTemp = nLongTemp /22;
        nLongTemp = nLongTemp /1024;
        nSampleValue = nLongTemp -40;
        //nSampleValue = nLongTemp /(220*1024) - 40;  //压力计算公式：(sample/1024 * nADVref (mV) / 220 欧  - 4mA) * 0.1MPa/mA *100 倍数
        sKYJ.sRunParam.nPressure = nSampleValue;  //压力=nSampleValue * 0.01MPa，如果是负值，很可能是没有接压力传感器，连4mA的电流都没有。 
        nCurrent = 0;
        nLongTemp = 0;
    }
    else if(nCurrentSampleCount <80)
    {
        nCurrent += adc_Get_Value(CH_Temperature);
    
    }
    else if(nCurrentSampleCount == 80)
    {
         //更新温度
        nCurrent += adc_Get_Value(CH_Temperature);
        nSampleValue = nCurrent/10;
        
        //测试用
        //nSampleValue = 500;

        nLongTemp = (long)nSampleValue*5000*100;  //是否有溢出的风险
        nSampleValue = nLongTemp/(21000-nSampleValue);  //得到电阻值，单位：0.01欧
        nLongTemp = (long)(nSampleValue - 10000) * 150 * 10 / 5700; 
        
        sKYJ.sRunParam.nTemperature = nLongTemp; //计算得到温度值，0.1度
        sKYJ.nTemperature = sKYJ.sRunParam.nTemperature/10;   //显示温度值   
        
        nCurrent = 0;
    }
    else if(nCurrentSampleCount <90)
    {
        nCurrent += adc_Get_Value(CH_Power);
    
    }
    else if(nCurrentSampleCount == 90)
    {
        //更新电源电压，RB3
        nCurrent += adc_Get_Value(CH_Power);
        nSampleValue = nCurrent/10;

        nLongTemp = (long)nSampleValue * nADVref * 6;  //采样电阻分压比5.5454：1，变压器变比11：1
        sKYJ.sRunParam.nVoltage = nLongTemp /102400; //假设电源电压到AD前的电压比是100：1    
        
        nCurrent = 0;
    }   
    //调试假设传感器值
//    sKYJ.sRunParam.nVoltage = 220;
//    sKYJ.sRunParam.nCurrentA = 100;
//    sKYJ.sRunParam.nCurrentB = 20;
//    sKYJ.sRunParam.nCurrentC = 30;
    //假设值结束，正常运行时请注释上面代码
    
    if(nCurrentSampleCount >= 100)
    {
        KYJ_CalcRegValue();
        nCurrentSampleCount = 0;
    }   
}

void KYJ_CalcRegValue(void)  //根据调整参数计算调整后的传感器数值
{
    //计算压力值
    sKYJ.nPressure = 0;
    if(sKYJ.sRunParam.nPressure>0)
        sKYJ.nPressure = sKYJ.sRunParam.nPressure;
//    sKYJ.nPressure = 50; //调试用
    //计算温度值
    sKYJ.nTemperature = ((long)sKYJ.sRunParam.nTemperature/10-sKYJ.sRegParam.nZeroBias)* sKYJ.sRegParam.nStandTempFactor/1000;

    //计算电源电压值
    sKYJ.nVoltage = (unsigned long)sKYJ.sRunParam.nVoltage * sKYJ.sRegParam.nStandVoltageFactor / 1000;

    //计算电流值
    sKYJ.nCurrentA = (unsigned long)sKYJ.sRegParam.nStandCurrentAFactor*sKYJ.sRunParam.nCurrentA/1000;
    sKYJ.nCurrentB = (unsigned long)sKYJ.sRegParam.nStandCurrentBFactor*sKYJ.sRunParam.nCurrentB/1000;
    sKYJ.nCurrentC = (unsigned long)sKYJ.sRegParam.nStandCurrentCFactor*sKYJ.sRunParam.nCurrentC/1000;
}

void KYJ_ShowRunParam(void)
{
    int nCurrent;
//    if(sKYJ.nInterface != INTERFACE_RUNPARAM) return;
    switch(nParamIndex)
    {
        case 1:  //主机电流
            nCurrent = max(sKYJ.nCurrentA,sKYJ.nCurrentB);
            nCurrent = max(nCurrent,sKYJ.nCurrentC);
            //如果处于停止状态，而且电流也没超过额定电流一半，则显示0
            if((sKYJ.nStatus & 0xF0)!=0 && nCurrent < sKYJ.sFactoryParam.nMainMotorNormalCurrent/2)
            {
                LcmPutFloatDigit(2,32,0,4,0,1);
                LcmPutFloatDigit(4,32,0,4,0,1);
                LcmPutFloatDigit(6,32,0,4,0,1);                
            }
            else
            {
                //nLongTemp = (unsigned long)sKYJ.sRunParam.nCurrentA * sKYJ.sRegParam.nStandCurrentAFactor;
                LcmPutFloatDigit(2,32,sKYJ.nCurrentA,4,0,1);
                //nLongTemp = (unsigned long)sKYJ.sRunParam.nCurrentB*sKYJ.sRegParam.nStandCurrentBFactor;
                LcmPutFloatDigit(4,32,sKYJ.nCurrentB,4,0,1);
                //nLongTemp = (unsigned long)sKYJ.sRunParam.nCurrentC*sKYJ.sRegParam.nStandCurrentCFactor;
                LcmPutFloatDigit(6,32,sKYJ.nCurrentC,4,0,1);
            }
            break;
        case 2:  //压力
            LcmPutFloatDigit(4,40,sKYJ.nPressure,4,0,2);
            break;
        case 3:  //运行总时间
            sKYJ.sRunParam.nTotalTime = sKYJ.sFactoryParam.nTotalRunTime / 60;
            LcmPutFixDigit(4,8,sKYJ.sRunParam.nTotalTime/10000,4,0);
            LcmPutFixDigit(4,40,sKYJ.sRunParam.nTotalTime%10000,4,0);
            break;

        case 4:  //负载总时间
            sKYJ.sRunParam.nLoadTime = sKYJ.sFactoryParam.nTotalLoadTime / 60;
            LcmPutFixDigit(4,8,sKYJ.sRunParam.nLoadTime/10000,4,0);
            LcmPutFixDigit(4,40,sKYJ.sRunParam.nLoadTime%10000,4,0);
            break;
        case 5:  //电源电压
            LcmPutFixDigit(4,40,sKYJ.nVoltage,4,0);
            break;
        default:
            LcmPutFixDigit(4,40,0,4,0);
            break;
    }
}

unsigned char KYJ_ValidateParam(void)  //验证设置参数，如果没有错误返回0，否则返回第一个错误参数序号
{
    //用户参数
    if(sKYJ.sUserParam.nLoadPress<1 
            || sKYJ.sUserParam.nLoadPress>=sKYJ.sUserParam.nUnLoadPress
            || sKYJ.sUserParam.nLoadPress>200) return 8;
    
    if(sKYJ.sUserParam.nUnLoadPress<1 
            || sKYJ.sUserParam.nUnLoadPress <= sKYJ.sUserParam.nLoadPress
            || sKYJ.sUserParam.nUnLoadPress>200
            || sKYJ.sUserParam.nUnLoadPress > sKYJ.sFactoryParam.nUnloadPressLimit) return 9;
    
    if(sKYJ.sUserParam.nFanStartTemp<1 
            || sKYJ.sUserParam.nFanStartTemp <= sKYJ.sUserParam.nFanStopTemp
            || sKYJ.sUserParam.nFanStartTemp >= sKYJ.sFactoryParam.nWarningTemp) return 1;
    
    if(sKYJ.sUserParam.nFanStopTemp<10 
            || sKYJ.sUserParam.nFanStopTemp >= sKYJ.sUserParam.nFanStartTemp) return 2;
    
    if(sKYJ.sUserParam.nMCUDelayTime<1 
            || sKYJ.sUserParam.nMCUDelayTime>100) return 3;
    
    if(sKYJ.sUserParam.nSADelayTime<1 
            || sKYJ.sUserParam.nSADelayTime>100) return 11;    
    
    if(sKYJ.sUserParam.nLoadDelayTime<1 
            || sKYJ.sUserParam.nLoadDelayTime>100) return 4;      
    
    if(sKYJ.sUserParam.nNoLoadDelayTime<1 
            || sKYJ.sUserParam.nNoLoadDelayTime>9000) return 5;    
    
    if(sKYJ.sUserParam.nStopDelayTime<1
            || sKYJ.sUserParam.nStopDelayTime >= sKYJ.sUserParam.nRestartDelayTime  //停机延时时间不能大于重启延时时间
            || sKYJ.sUserParam.nStopDelayTime>1000) return 6;     
    
    if(sKYJ.sUserParam.nRestartDelayTime<1 
            || sKYJ.sUserParam.nRestartDelayTime>1000) return 7;    
    //厂家参数
    
    if(sKYJ.sFactoryParam.nMainMotorNormalCurrent<1
            ||sKYJ.sFactoryParam.nMainMotorNormalCurrent>9000) return 101;
    
    if(sKYJ.sFactoryParam.nWarningTemp<1
            ||sKYJ.sFactoryParam.nWarningTemp>150
            ||sKYJ.sFactoryParam.nWarningTemp >= sKYJ.sFactoryParam.nStopTemp ) return 102;

    if(sKYJ.sFactoryParam.nStopTemp<1
            ||sKYJ.sFactoryParam.nStopTemp>150
            ||sKYJ.sFactoryParam.nStopTemp <= sKYJ.sFactoryParam.nWarningTemp ) return 103;

    if(sKYJ.sFactoryParam.nStopPress<1
            ||sKYJ.sFactoryParam.nStopPress>200
            ||sKYJ.sFactoryParam.nStopPress <= sKYJ.sFactoryParam.nUnloadPressLimit ) return 104;    
    
    if(sKYJ.sFactoryParam.nUnloadPressLimit<1
            ||sKYJ.sFactoryParam.nUnloadPressLimit>200
            ||sKYJ.sFactoryParam.nUnloadPressLimit >= sKYJ.sFactoryParam.nStopPress ) return 105;
    
    if(sKYJ.sFactoryParam.nLowTempProtect<1
            ||sKYJ.sFactoryParam.nLowTempProtect>100) return 108;    
    
    if(sKYJ.sFactoryParam.nCurrentNotBalance<1
            ||sKYJ.sFactoryParam.nCurrentNotBalance>20) return 109;

    if(sKYJ.sFactoryParam.nStartType != 0
            && sKYJ.sFactoryParam.nStartType != 1) return 10;
    //调整参数
    return 0;
}
