isliulin/MingRui/KYJ.X/SRC/LCD_LIXIAN.h

#ifndef	__LCD_LIXIAN_h__
#define	__LCD_LIXIAN_h__
#include <xc.h>
//#include <intrins.h>
#define  CS PORTDbits.RD2
#define  RS PORTDbits.RD0
#define RES PORTDbits.RD1
#define  SCK PORTCbits.RC3
#define SID PORTCbits.RC5

#define	LcmXPixel 128	//横向宽度
#define	LcmYPixel 64	//纵向高度
#define MIN(A,B) ((A)<(B)?(A):(B))
#define Uchar unsigned char
#define Uint  unsigned int
#define code const


//Uchar code ASCIIchardot[];
unsigned char BuffCharDot[8];
//Uchar code bmp1[];
//Uchar code bmp2[];
//Uchar code bmp3[];
Uchar code ComTable[]={7,6,5,4,3,2,1,0,};

void WriteCommand( Uchar CommandByte );
void WriteData( Uchar DataByte );
void LcmClear( Uchar FillData );
void LcmInit( void );
void LcmPutChar(Uchar col,Uchar page,Uchar Order);
void LcmPutStr(Uchar col,Uchar page,Uchar *puts);
//void LcmPutNum(Uchar col,Uchar page,Uchar Num);
void LcmPutNum(unsigned char col,unsigned char page,int Num);
void LcmPutFixDigit(unsigned char page,unsigned char col, int Num, unsigned char nLen, unsigned char nInvIndex);
void LcmPutFloatDigit(unsigned char page,unsigned char col, int Num, unsigned char nLen, unsigned char nInvIndex, unsigned char nDotIndex);
void LcmPutCharInv(Uchar col,Uchar page,Uchar Order);
void LcmPutBmp( Uchar *puts );
void LcmPutCChar(void);
void LcmPutSongStr(unsigned char nLine, unsigned char nCol,unsigned char nCharIndex[],unsigned char nLen, unsigned char nInv);
void LcmSetSongBuff(unsigned char ch1,unsigned char ch2,unsigned char ch3,unsigned char ch4,unsigned char ch5,unsigned char ch6,unsigned char ch7,unsigned char ch8);
/*中文字库*/
unsigned char code SONGchardot[246][16] = {
{0x20,0x24,0x22,0x21,0x26,0x39,0x02,0x0C,0xF0,0x13,0x10,0x10,0x14,0x18,0x00,0x00},
{0x08,0x10,0x60,0x80,0x41,0x32,0x04,0x18,0x60,0x80,0x60,0x18,0x04,0x02,0x01,0x00},/*"欢",0*/
{0x02,0x02,0x42,0x33,0x00,0x00,0x3F,0x20,0x40,0x00,0x3F,0x20,0x20,0x3F,0x00,0x00},
{0x00,0x02,0x04,0xF8,0x04,0x02,0xF2,0x22,0x42,0x02,0xFE,0x42,0x22,0xC2,0x02,0x00},/*"迎",1*/
{0x01,0x06,0x1F,0xE0,0x20,0x27,0x24,0x24,0x24,0xFF,0x24,0x24,0x24,0x27,0x20,0x00},
{0x00,0x00,0xFF,0x00,0x01,0x81,0xA2,0x94,0x88,0xF4,0x82,0x82,0x81,0x81,0x01,0x00},/*"使",2*/
{0x00,0x00,0x7F,0x44,0x44,0x44,0x44,0x7F,0x44,0x44,0x44,0x44,0x7F,0x00,0x00,0x00},
{0x01,0x06,0xF8,0x40,0x40,0x40,0x40,0xFE,0x40,0x40,0x42,0x41,0xFE,0x00,0x00,0x00},/*"用",3*/
{0x00,0x1F,0x10,0xFF,0x10,0x1F,0x00,0x7C,0x55,0x56,0x7C,0x54,0x55,0x7C,0x00,0x00},
{0x04,0xC6,0x84,0xF8,0x88,0x9C,0x12,0x94,0x90,0xB1,0xDF,0x90,0x10,0x34,0x1A,0x00},/*"螺",0*/
{0x08,0x08,0x0B,0xFF,0x09,0x08,0x01,0x41,0x41,0x41,0x7F,0x41,0x41,0x41,0x01,0x00},
{0x20,0xC0,0x00,0xFF,0x00,0xC0,0x00,0x00,0x00,0x00,0xFF,0x00,0x00,0x00,0x00,0x00},/*"杆",1*/
{0x00,0x00,0x7F,0x40,0x41,0x41,0x41,0x41,0x5F,0x41,0x41,0x41,0x41,0x41,0x40,0x00},
{0x01,0x06,0xF8,0x02,0x02,0x02,0x02,0x02,0xFE,0x02,0x02,0x22,0x1A,0x02,0x02,0x00},/*"压",2*/
{0x04,0x1C,0xE7,0x0C,0x00,0x31,0x23,0x2C,0x24,0xA4,0x65,0x26,0x24,0x24,0x34,0x00},
{0x44,0xE4,0x48,0x48,0x80,0x00,0xFF,0x00,0x00,0xFF,0x92,0x92,0x92,0xFF,0x00,0x00},/*"缩",3*/
{0x08,0x08,0x0B,0xFF,0x09,0x08,0x00,0x7F,0x40,0x40,0x40,0x7F,0x00,0x00,0x00,0x00},
{0x20,0xC0,0x00,0xFF,0x00,0xC1,0x06,0xF8,0x00,0x00,0x00,0xFC,0x02,0x02,0x1E,0x00},/*"机",4*/
{0x08,0x06,0x40,0x31,0x00,0x00,0x7F,0x49,0x49,0x49,0x49,0x49,0x7F,0x00,0x00,0x00},
{0x20,0x20,0x7E,0x80,0x02,0x7E,0x42,0x42,0x7E,0x42,0x7E,0x42,0x42,0x7E,0x02,0x00},/*"温",0*/
{0x00,0x00,0x3F,0x24,0x24,0x24,0x3F,0xA4,0x64,0x24,0x3F,0x24,0x24,0x24,0x20,0x00},
{0x02,0x0C,0xF1,0x01,0x21,0x32,0xAA,0xA4,0xA4,0xA4,0xAA,0x32,0x01,0x01,0x01,0x00},/*"度",1*/
{0x60,0x90,0x90,0x67,0x1F,0x30,0x20,0x40,0x40,0x40,0x40,0x40,0x20,0x78,0x00,0x00},
{0x00,0x00,0x00,0xE0,0xF8,0x0C,0x04,0x02,0x02,0x02,0x02,0x02,0x04,0x08,0x00,0x00},/*"℃",2*/
{0x02,0x02,0x42,0x33,0x00,0x02,0x05,0x79,0x41,0x41,0x41,0x79,0x05,0x04,0x04,0x00},
{0x00,0x00,0x00,0xFC,0x09,0x11,0x02,0xC2,0x34,0x08,0x14,0x62,0x82,0x01,0x01,0x00},/*"设",3*/
{0x01,0x09,0x09,0x12,0x32,0xEA,0x24,0x24,0x24,0x2A,0x32,0x22,0x01,0x01,0x01,0x00},
{0x00,0x00,0x00,0xFF,0x92,0x92,0x92,0xFE,0x92,0x92,0x92,0xFF,0x00,0x00,0x00,0x00},/*"备",4*/
{0x00,0x00,0x47,0x41,0x41,0x41,0x41,0x41,0x41,0x41,0x41,0x7F,0x00,0x00,0x00,0x00},
{0x00,0x00,0xFC,0x02,0x02,0x02,0x02,0x02,0x02,0x02,0x02,0x02,0x02,0x1E,0x00,0x00},/*"已",5*/
{0x04,0x0C,0x35,0xC6,0x04,0x18,0x01,0x41,0x42,0x44,0x48,0x58,0x64,0x42,0x01,0x00},
{0x44,0xE6,0x44,0x48,0x48,0x48,0x02,0x42,0x42,0x42,0x7E,0x42,0x42,0x42,0x02,0x00},/*"经",6*/
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
/*--  Fixedsys12;  此字体下对应的点阵为：宽x高=8x16   --*/
0x0C,0x18,0x10,0x18,0x0C,0x04,0x0C,0x18,0x00,0x00,0x00,0x00,0x00,0x00,0x00,0x00,

/*--  文字:    --*/
/*--  Fixedsys12;  此字体下对应的点阵为：宽x高=8x16   --*/
0x00,0x1F,0x1F,0x1F,0x1F,0x1F,0x1F,0x00,0x00,0xF0,0xF0,0xF0,0xF0,0xF0,0xF0,0x00
};


#endif
