isliulin/MingRui/KYJ.X/SRC/EEPROM.c

#include<xc.h>
#include "EEPROM.h"
#include "KYJDEF.h"
#include "delay.h"
void EEPROM_Write(unsigned char nAddr, unsigned char nData)
{
    EEADR = nAddr;
    EEADRH = 0; //没用到高位，要存储的最大地址是0XAE
    EEDATA = nData;
    CFGS = 0;
    EEPGD = 0;
    WREN = 1;
    GIE = 0;
    EECON2 = 0x55;
    EECON2 = 0xAA;
    EECON1bits.WR = 1;
    GIE = 1;
    WREN = 0;
    while (EECON1bits.WR==1){;}
}

unsigned char EEPROM_Read(unsigned char nAddr)
{
    EEADR = nAddr;
    EEADRH  = 0; //没用到高位，要存储的最大地址是0XAE
    CFGS = 0;
    EEPGD = 0;
    EECON1bits.RD = 1;
    return EEDATA;
}

void EEPROM_Save_Param(unsigned char nBytes)
{
    unsigned char * nAddr;
    unsigned char i;
    nAddr = &sKYJ.sUserParam;
    for(i=0;i<nBytes;i++)
    {
        EEPROM_Write(EEPROM_PARAM_ADDR+i,*nAddr++);

    }
}

void EEPROM_Load_Param(unsigned char nBytes)
{
    unsigned char * nAddr;
    unsigned char i;
    nAddr = &sKYJ.sUserParam;
    for(i=0;i<nBytes;i++)
    {
        *nAddr++=EEPROM_Read(EEPROM_PARAM_ADDR+i);
    }
}

void EEPROM_Save_Counter(void)  //保存各计数值
{
    unsigned char * nAddr;
    unsigned char i;
    nAddr = &sKYJ.sFactoryParam.nTotalRunTime;
    for(i=0;i<8;i++)  //nTotalRunTime 和 nTotalLoadTime 共8个字节。
    {
        EEPROM_Write(EEPROM_COUNTER_ADDR+i,*nAddr++);
    }
    
}

void EEPROM_Load_Counter(void) //读取各计数值
{
    unsigned char * nAddr;
    unsigned char i;
    nAddr = &sKYJ.sFactoryParam.nTotalRunTime;
    for(i=0;i<8;i++) //nTotalRunTime 和 nTotalLoadTime 共8个字节。
    {
        *nAddr++=EEPROM_Read(EEPROM_COUNTER_ADDR+i);
    }    
}
