isliulin/MingRui/(commit log)

2015-11-26 initial again
    [KYJController.PCB, KYJController.Sch]
2015-11-29 添加忽略列表，新建MPLab X IDE项目文件
2015-11-29 新建项目文件
2015-12-22 端口配置代码
2016-01-04 字库，菜单操作
    [汉字.xlsx]
2016-01-07 完善了状态切换
    [汉字.xlsx]
2016-01-26 基本功能完成第一版
    已完成基本功能。未优化。
2016-03-31 PIC16F1939 Last Version
    使用1939的最后一个版本，后续版本改为18F46K80
2016-04-12 PIC18F46K20
    换用PIC18F46K20芯片
    [矩阵开关.pcb]
2016-04-14 46K20端口配置
    针对46K20进行了端口配置，ADC仍旧没有验证。修改了sKYJ结构体中部分数据。
2016-04-21 增加电源电压和星角启动
    增加电源电压参数查看，调整；增加星角延时时间用户参数设置。重新整理了sKYJ的变量，主要是把校正计算前的数据放在RunParam中，校正后的放在sKYJ下。增加星角启动。目前发现在Pro下编译后程序显示很慢。
    [汉字.xlsx]
2016-04-22 修正了一些问题
    时间流逝改为倒计时。检查了状态检测代码。adc改成12Tad。SPI通讯中SCK之间的delay去掉了，解决了显示刷新速度慢的问题。
2016-04-26 修正了AD转换问题
    因为分别在主程序和中断中调用ad转换，导致主程序ad总是出错。现统一到中断中去。
2016-04-26 minus revision
    细微调整
2016-04-28 V2基本完成版
    改用倒计时；压力，温度，电压采用多次采样取平均值；电流不平衡和过流保护躲避启动时间。未解决的问题：过流保护曲线未实现。
2016-05-05 现场测量版本
    修正了压力测量问题，long整型，24位，可能是溢出问题。
    三相电流测量波动比较大，改用峰值后有所改善，但是仍旧波动比较大，可能需要加RC滤波。
2016-06-22 第一次安装调试版本
    三相电流测量需要调试，增加紧急按钮判断，显示延时状态信息。
    [KYJ.DWG, KYJ.PCB]
2016-06-23 第一次安装调试版本修订
    应急开关正常时常闭
2016-08-26 第二次安装版本
    解决液晶花瓶问题：定时重新初始化液晶模块。更改默认参数值。增加运行总时间和负载总时间参数。
2016-09-08 改进参数保存问题，增加参数验证保护
    不在检测到掉电时保存所有参数，仅保存运行时间共4个字节。因此，增加一个函数EEPROM_Save_Counter
    增加KYJ_ValidateParam函数，验证参数是否在允许范围内，返回值为参数序号，跟菜单里的顺序一致。0**的为用户参数，1**的为厂家参数。分别在启动时和更改参数时检查。同时在故障检测中增加D9位表示参数保护，sKYJ结构体中增加nValidateParamResult变量保存参数检查结果。故障检测时检查该变量是否为0，否则显示参数保护，并显示参数序号。
2016-09-09 增加密码，过流反时限
    增加用户密码和厂家密码功能。增加过流反时限保护，电流不平衡保护修改为计时。过流和不平衡保护只在运行时检测。
2016-09-16 第三次安装版本
    计时值的保存放到switch to keystop中，不在掉电保护里保存。蜂鸣器和指示灯开始工作，启用开门狗。
2016-09-27 增加外壳模型
    外壳模型文件
    [壳体后盖.STEP, 壳体后盖.x_t, 面板壳体.STEP, 面板壳体.x_t]
2017-08-18 EEPROM
    修正参数保存读取bug
